mathijsmeulendijks/nrf9151-modbus/manufacturing/default/default.jlcpcb/default.bom.csv

Designator | Footprint | Quantity | Manufacturer | Partnumber | LCSC Part # | Comment
C1, C2, C6, C8, C11, C12, C17, C20, C24, C25, C29, C35, C39 | Murata_Electronics_GRM155F51C104ZA01D | 13 | Murata Electronics | GRM155F51C104ZA01D | C363930 | 100nF 16V
C3, C4 | KEMET_C0402C220K4RACAUTO | 2 | KEMET | C0402C220K4RACAUTO | C1864677 | 22pF ±10% 16V
C5 | TDK_C1608X5R1V475KT000E | 1 | TDK | C1608X5R1V475KT000E | C329940 | 4.7µF ±10% 35V
C7, C15, C16, C19, C34, C38 | HRE_CGA0603X5R105K350JT | 6 | HRE | CGA0603X5R105K350JT | C6119865 | 1µF ±10% 35V
C9, C26 | TDK_C3216X6S1A476MTJ00E | 2 | TDK | C3216X6S1A476MTJ00E | C432922 | 47µF ±20% 10V
C10, C13, C22, C32, C36 | FH_0805F106M100NT | 5 | FH | 0805F106M100NT | C91158 | 10µF ±20% 10V
C14, C21, C33, C37 | Walsin_Tech_Corp_0402B103K500 | 4 | Walsin Tech Corp | 0402B103K500 | C83062 | 10nF 50V
C18 | SANYEAR_C1206X5R107M160NT | 1 | SANYEAR | C1206X5R107M160NT | C2911415 | 100µF 16V
C23 | FOJAN_FCC0805X226M100FT | 1 | FOJAN | FCC0805X226M100FT | C5137600 | 22µF ±20% 10V
C27, C28, C30, C31 | Murata_Electronics_GCM188R71E104JA57D | 4 | Murata Electronics | GCM188R71E104JA57D | C437462 | 100nF ±5% 25V
Card1 | XKB_Connection_XKSIM_008 | 1 | XKB Connection | XKSIM-008 | C381069
D1, D2, D3, D4 | Nexperia_PESD5V0F1BL_315 | 4 | Nexperia | PESD5V0F1BL,315 | C45961
D5 | STMicroelectronics_USBLC6_2SC6 | 1 | STMicroelectronics | USBLC6-2SC6 | C7519
D6 | Diodes_Incorporated_SMAJ5_0A_13_F | 1 | Diodes Incorporated | SMAJ5.0A-13-F | C87074
F1 | Xucheng_Elec_5x20_BLX_AType_Fuse_holder_XC_7 | 1 | Xucheng Elec | 5x20 BLX-AType Fuse holder XC-7 | C3131
L1 | Murata_Electronics_BLM18KG300TN1D | 1 | Murata Electronics | BLM18KG300TN1D | C88982
Q1 | Alpha_Omega_Semicon_AO4407A | 1 | Alpha & Omega Semicon | AO4407A | C16072
R1, R6, R11, R12, R19, R20, R22 | YAGEO_RT0402DRE0710KL | 7 | YAGEO | RT0402DRE0710KL | C326912 | 10kΩ ±0.5% 62.5mW 50V
R2, R21 | YAGEO_RT0603BRD07121RL | 2 | YAGEO | RT0603BRD07121RL | C705721 | 121Ω ±0.1% 100mW 75V
R3, R4 | Viking_Tech_CR_02FL6_4K7 | 2 | Viking Tech | CR-02FL6---4K7 | C406732 | 4.7kΩ ±1% 62.5mW 50V
R5 | KOA_Speer_Elec_RN73H1ETTP49R9D10 | 1 | KOA Speer Elec | RN73H1ETTP49R9D10 | C4165090 | 49.9Ω ±0.5% 62.5mW
R7, R8, R9 | ROHM_Semicon_MCR01MZPJ220 | 3 | ROHM Semicon | MCR01MZPJ220 | C2941037 | 22Ω ±5% 100mW 50V
R10, R14 | HKR_AST02100KJ | 2 | HKR | AST02100KJ | C49330106 | 100kΩ ±5% 62.5mW 50V
R13 | FH_RC_02K102JT | 1 | FH | RC-02K102JT | C140196 | 1kΩ ±5% 62.5mW 50V
R15, R16 | Ever_Ohms_Tech_QR0402F100KQ10Z | 2 | Ever Ohms Tech | QR0402F100KQ10Z | C176106 | 100kΩ ±1% 63mW 50V
R17 | Vishay_Intertech_RCWE1206R100FKEA | 1 | Vishay Intertech | RCWE1206R100FKEA | C844256 | 100mΩ ±1% 500mW
R18 | ROHM_Semicon_TRR01MZPF4022 | 1 | ROHM Semicon | TRR01MZPF4022 | C5966383 | 40.2kΩ ±1% 63mW
RF1, RF2 | ECT_ECT818000500 | 2 | ECT | ECT818000500 | C437254
RJ1 | Shenzhen_Kinghelm_Elec_KH_RJ45_56_8P8C | 1 | Shenzhen Kinghelm Elec | KH-RJ45-56-8P8C | C2683359
SW1 | Korean_Hroparts_Elec_K2_1102SP_D4SC_04 | 1 | Korean Hroparts Elec | K2-1102SP-D4SC-04 | C223763
U1 | Microchip_Tech_MCP2515T_I_SO | 1 | Microchip Tech | MCP2515T-I/SO | C153782
U2 | Texas_Instruments_SN65HVD230DR | 1 | Texas Instruments | SN65HVD230DR | C12084
U3 | Nordic_Semicon_NRF9151_LACA_R | 1 | Nordic Semicon | NRF9151-LACA-R | C42236596
U4 | JLCPCB_Assembly_FTSH_105_01_F_D_K | 1 | JLCPCB Assembly | FTSH-105-01-F-D-K | C9900011230
U5 | Texas_Instruments_INA180A1IDBVR | 1 | Texas Instruments | INA180A1IDBVR | C122228
U6 | Microchip_Tech_MCP6001UT_I_OT | 1 | Microchip Tech | MCP6001UT-I/OT | C21403
U7 | MW_IRM_10_5 | 1 | MW | IRM-10-5 | C2857903
U8 | Texas_Instruments_TLV1117_33CDCYR | 1 | Texas Instruments | TLV1117-33CDCYR | C91728
U9, U10 | Texas_Instruments_LM66100DCKR | 2 | Texas Instruments | LM66100DCKR | C2869734
U11 | JLCPCB_Assembly_0_47F5_5VDC | 1 | JLCPCB Assembly | 0.47F5.5VDC | C9900166265
U12 | Diodes_Incorporated_APX803L_29SA_7 | 1 | Diodes Incorporated | APX803L-29SA-7 | C2066862
U13 | Texas_Instruments_MAX3232IPWR | 1 | Texas Instruments | MAX3232IPWR | C113205
U14 | Texas_Instruments_ISOW1412DFMR | 1 | Texas Instruments | ISOW1412DFMR | C5216548
U15 | Texas_Instruments_TMP117AIDRVR | 1 | Texas Instruments | TMP117AIDRVR | C699536
XTAL1 | IQD_LFXTAL056516REEL | 1 | IQD | LFXTAL056516REEL | C6078914 | 8MHz
