mathijsmeulendijks/nrf9151-modbus/layouts/default/default.pcb.hl/3d_models/JLCPCB_Assembly_0_47F5_5VDC/JLCPCB_Assembly_0_47F5_5VDC.3dmodel.step

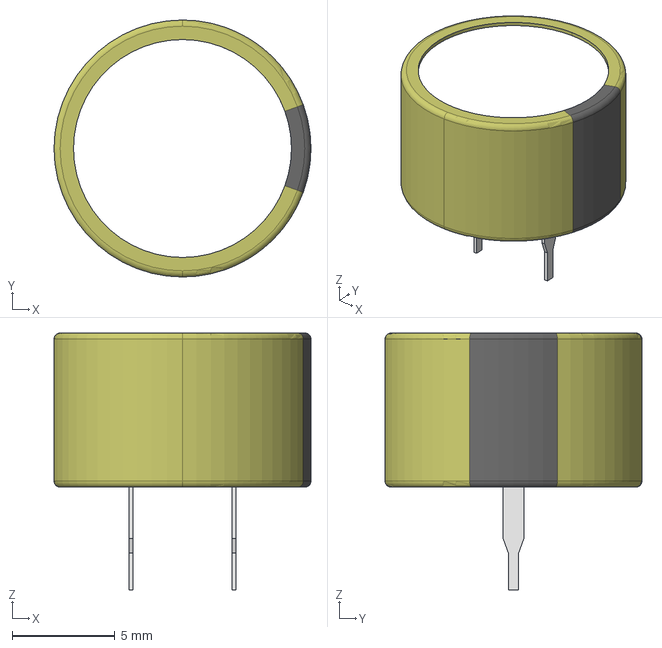
[picture p1: CAD file, 2026-10-01]
layouts/default/default.pcb.hl/3d_models/JLCPCB_Assembly_0_47F5_5VDC/JLCPCB_Assembly_0_47F5_5VDC.3dmodel.step
12.5 x 12.5 x 12.5 mm
