mathijsmeulendijks/nrf9151-modbus/layouts/default/default.pcb.hl/3d_models/JLCPCB_Assembly_FTSH_105_01_F_D_K/JLCPCB_Assembly_FTSH_105_01_F_D_K.3dmodel.step

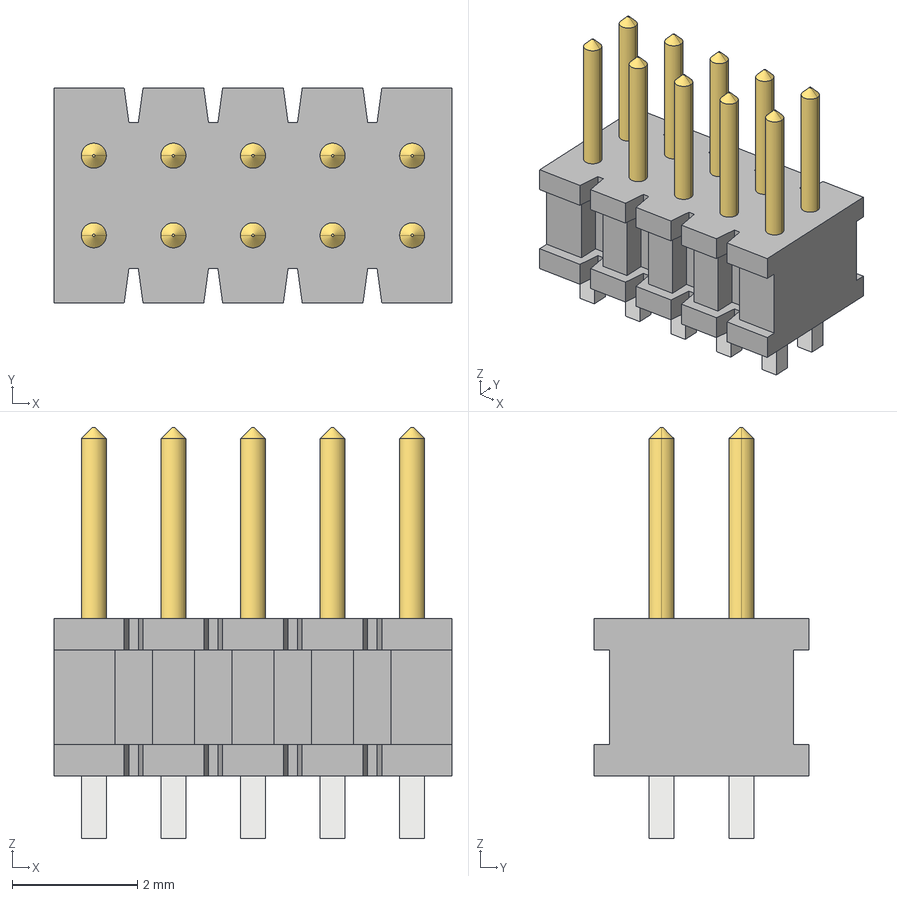
[picture p2: CAD file, 2026-10-01]
layouts/default/default.pcb.hl/3d_models/JLCPCB_Assembly_FTSH_105_01_F_D_K/JLCPCB_Assembly_FTSH_105_01_F_D_K.3dmodel.step
6.35 x 3.43 x 6.56 mm
