mathijsmeulendijks/nrf9151-modbus/layouts/default/default.pcb.hl/3d_models/Diodes_Incorporated_APX803L_29SA_7/Diodes_Incorporated_APX803L_29SA_7.3dmodel.step

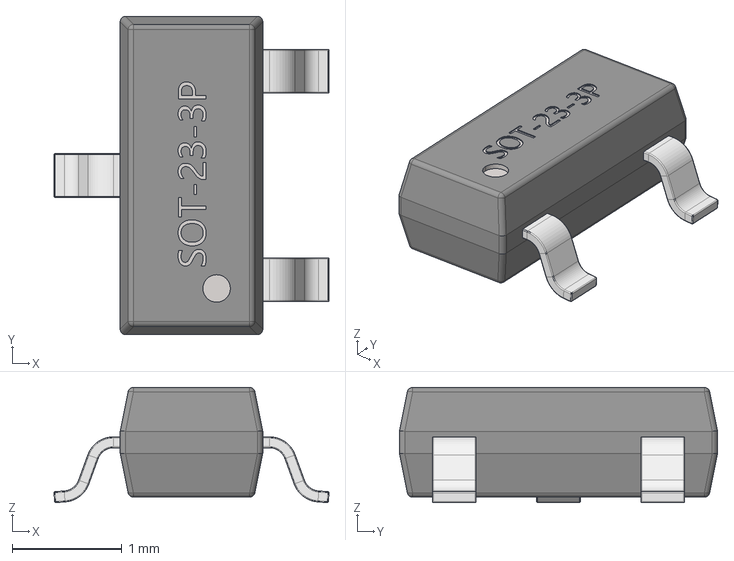
[picture p3: CAD file, 2026-10-01]
layouts/default/default.pcb.hl/3d_models/Diodes_Incorporated_APX803L_29SA_7/Diodes_Incorporated_APX803L_29SA_7.3dmodel.step
2.51 x 2.90 x 1.05 mm
