mathijsmeulendijks/nrf9151-modbus/layouts/default/default.pcb.hl/3d_models/Diodes_Incorporated_SMAJ5_0A_13_F/Diodes_Incorporated_SMAJ5_0A_13_F.3dmodel.step

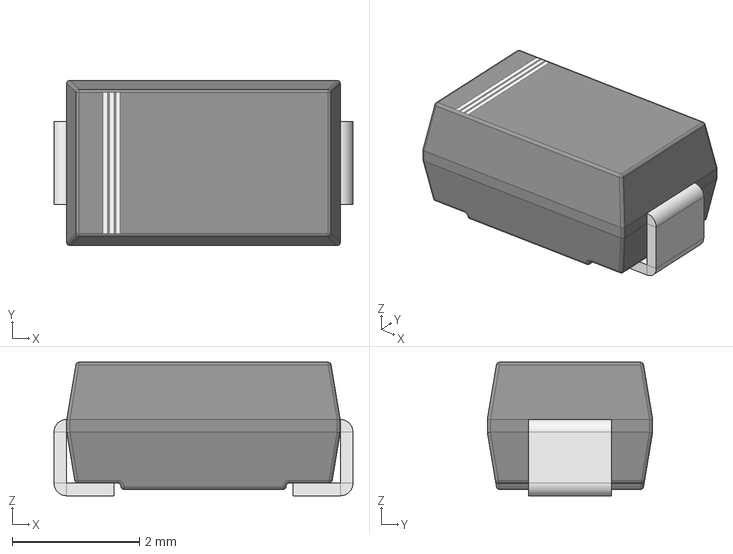
[picture p4: CAD file, 2026-10-01]
layouts/default/default.pcb.hl/3d_models/Diodes_Incorporated_SMAJ5_0A_13_F/Diodes_Incorporated_SMAJ5_0A_13_F.3dmodel.step
4.70 x 2.60 x 2.10 mm
