mathijsmeulendijks/nrf9151-modbus/layouts/default/default.pcb.hl/3d_models/ECT_ECT818000500/ECT_ECT818000500.3dmodel.step

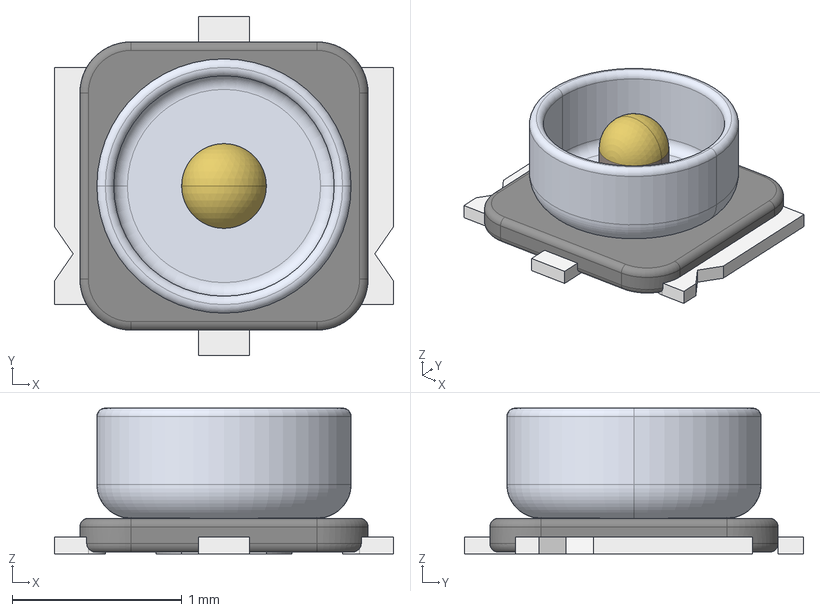
[picture p5: CAD file, 2026-10-01]
layouts/default/default.pcb.hl/3d_models/ECT_ECT818000500/ECT_ECT818000500.3dmodel.step
2.00 x 2.00 x 0.86 mm
