mathijsmeulendijks/nrf9151-modbus/layouts/default/default.pcb.hl/3d_models/FH_0805F106M100NT/FH_0805F106M100NT.3dmodel.step

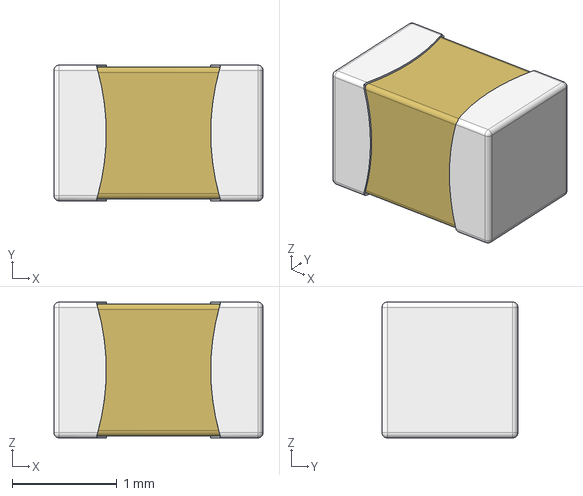
[picture p6: CAD file, 2026-10-01]
layouts/default/default.pcb.hl/3d_models/FH_0805F106M100NT/FH_0805F106M100NT.3dmodel.step
2.00 x 1.30 x 1.30 mm
