mathijsmeulendijks/nrf9151-modbus/layouts/default/default.pcb.hl/3d_models/HRE_CGA0603X5R105K350JT/HRE_CGA0603X5R105K350JT.3dmodel.step

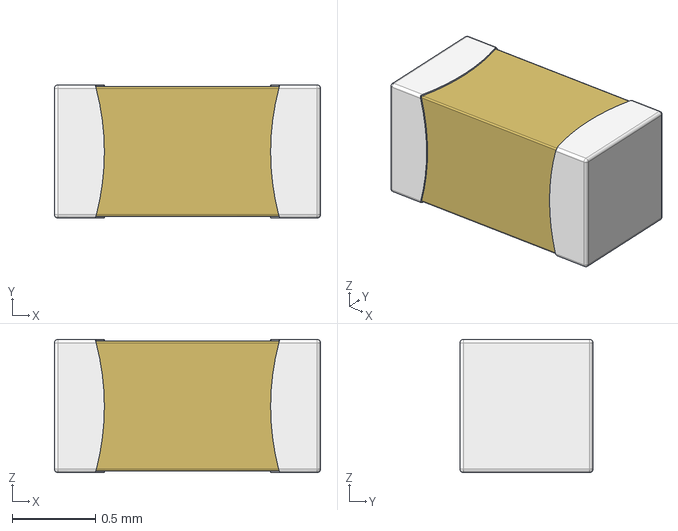
[picture p7: CAD file, 2026-10-01]
layouts/default/default.pcb.hl/3d_models/HRE_CGA0603X5R105K350JT/HRE_CGA0603X5R105K350JT.3dmodel.step
1.60 x 0.8 x 0.8 mm
