mathijsmeulendijks/nrf9151-modbus/layouts/default/default.pcb.hl/3d_models/IQD_LFXTAL056516REEL/IQD_LFXTAL056516REEL.3dmodel.step

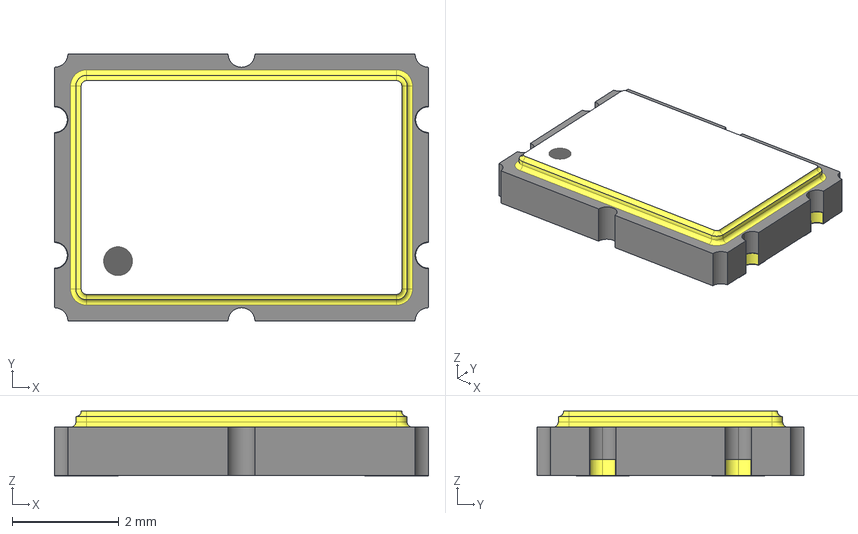
[picture p8: CAD file, 2026-10-01]
layouts/default/default.pcb.hl/3d_models/IQD_LFXTAL056516REEL/IQD_LFXTAL056516REEL.3dmodel.step
7.00 x 5.00 x 1.21 mm
