mathijsmeulendijks/nrf9151-modbus/layouts/default/default.pcb.hl/3d_models/Korean_Hroparts_Elec_K2_1102SP_D4SC_04/Korean_Hroparts_Elec_K2_1102SP_D4SC_04.3dmodel.step

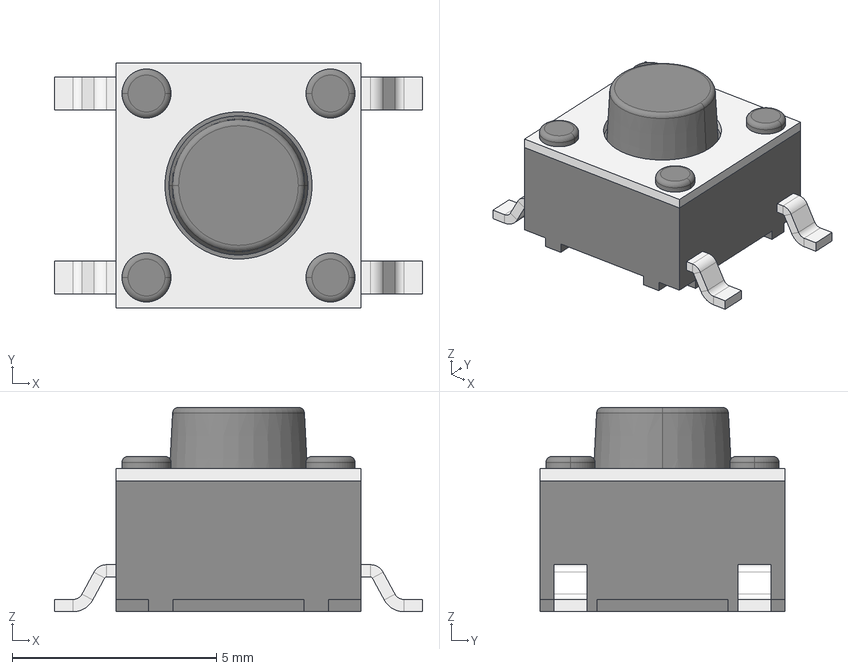
[picture p9: CAD file, 2026-10-01]
layouts/default/default.pcb.hl/3d_models/Korean_Hroparts_Elec_K2_1102SP_D4SC_04/Korean_Hroparts_Elec_K2_1102SP_D4SC_04.3dmodel.step
9.00 x 6.00 x 5.00 mm
