mathijsmeulendijks/nrf9151-modbus/layouts/default/default.pcb.hl/3d_models/Microchip_Tech_MCP2515T_I_SO/Microchip_Tech_MCP2515T_I_SO.3dmodel.step

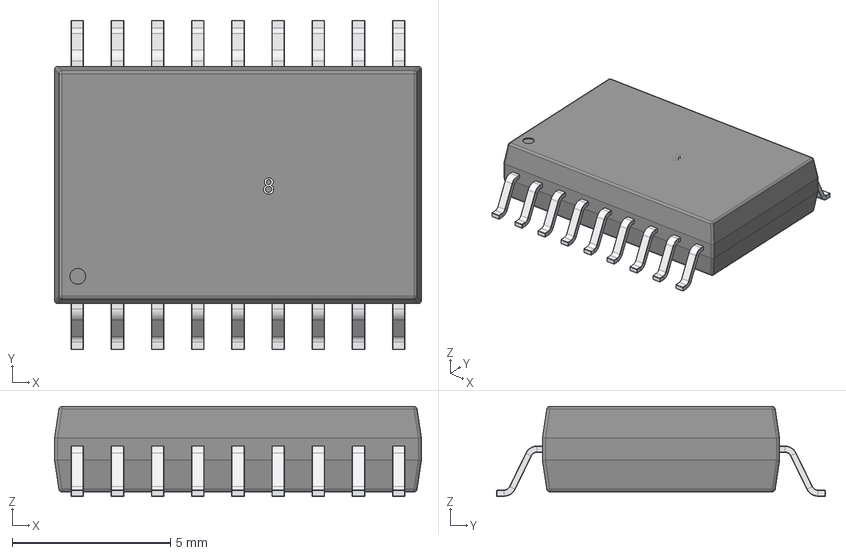
[picture p10: CAD file, 2026-10-01]
layouts/default/default.pcb.hl/3d_models/Microchip_Tech_MCP2515T_I_SO/Microchip_Tech_MCP2515T_I_SO.3dmodel.step
11.6 x 10.4 x 2.85 mm
