mathijsmeulendijks/nrf9151-modbus/layouts/default/default.pcb.hl/3d_models/Microchip_Tech_MCP6001UT_I_OT/Microchip_Tech_MCP6001UT_I_OT.3dmodel.step

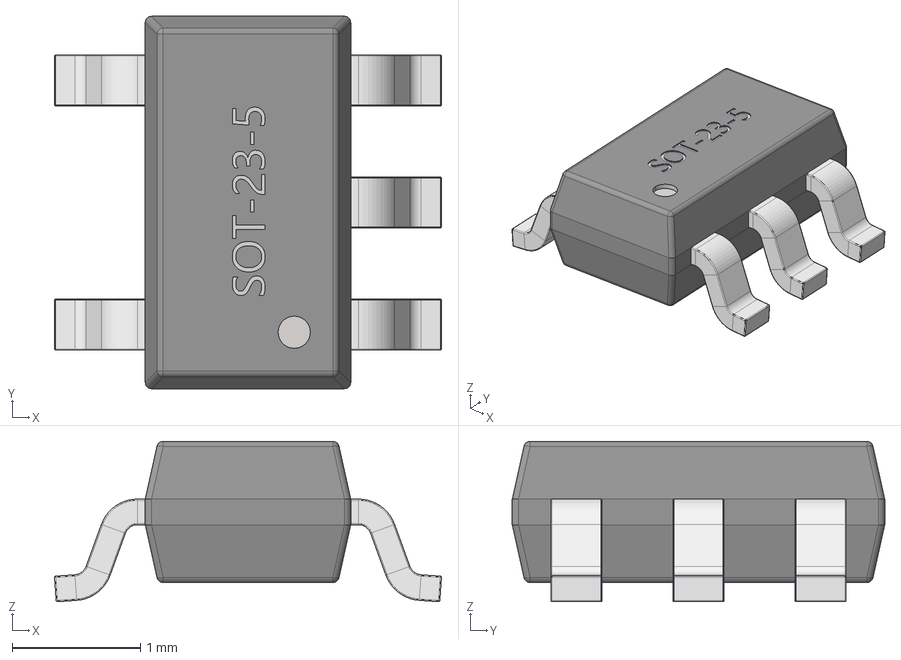
[picture p11: CAD file, 2026-10-01]
layouts/default/default.pcb.hl/3d_models/Microchip_Tech_MCP6001UT_I_OT/Microchip_Tech_MCP6001UT_I_OT.3dmodel.step
3.01 x 2.90 x 1.25 mm
