mathijsmeulendijks/nrf9151-modbus/layouts/default/default.pcb.hl/3d_models/Murata_Electronics_BLM18KG300TN1D/Murata_Electronics_BLM18KG300TN1D.3dmodel.step

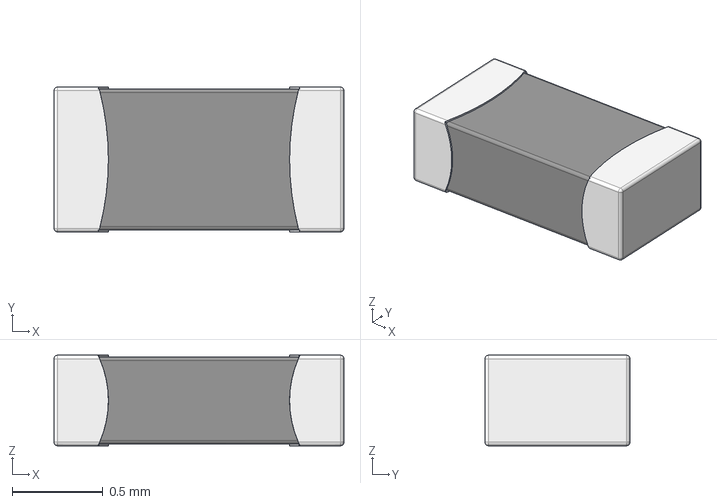
[picture p12: CAD file, 2026-10-01]
layouts/default/default.pcb.hl/3d_models/Murata_Electronics_BLM18KG300TN1D/Murata_Electronics_BLM18KG300TN1D.3dmodel.step
1.60 x 0.8 x 0.5 mm
