mathijsmeulendijks/nrf9151-modbus/layouts/default/default.pcb.hl/3d_models/Murata_Electronics_GRM155F51C104ZA01D/Murata_Electronics_GRM155F51C104ZA01D.3dmodel.step

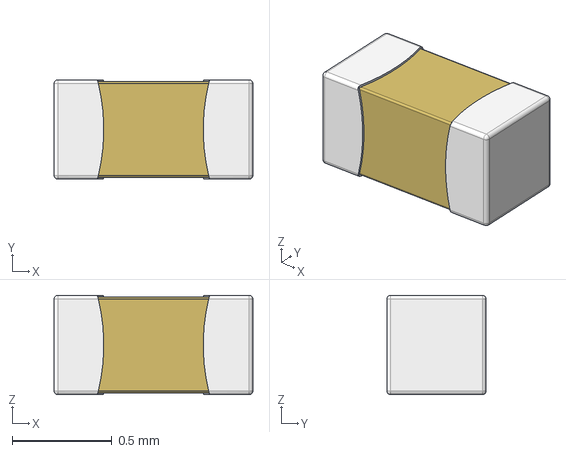
[picture p13: CAD file, 2026-10-01]
layouts/default/default.pcb.hl/3d_models/Murata_Electronics_GRM155F51C104ZA01D/Murata_Electronics_GRM155F51C104ZA01D.3dmodel.step
1.00 x 0.5 x 0.5 mm
