mathijsmeulendijks/nrf9151-modbus/layouts/default/default.pcb.hl/3d_models/MW_IRM_10_5/MW_IRM_10_5.3dmodel.step

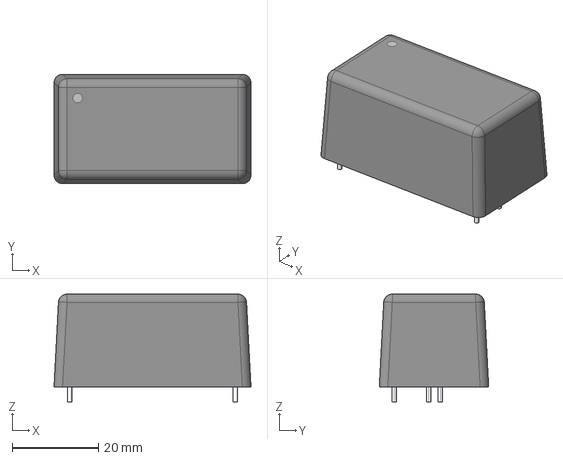
[picture p14: CAD file, 2026-10-01]
layouts/default/default.pcb.hl/3d_models/MW_IRM_10_5/MW_IRM_10_5.3dmodel.step
45.7 x 25.4 x 25.0 mm
