mathijsmeulendijks/nrf9151-modbus/layouts/default/default.pcb.hl/3d_models/Nexperia_PESD5V0F1BL_315/Nexperia_PESD5V0F1BL_315.3dmodel.step

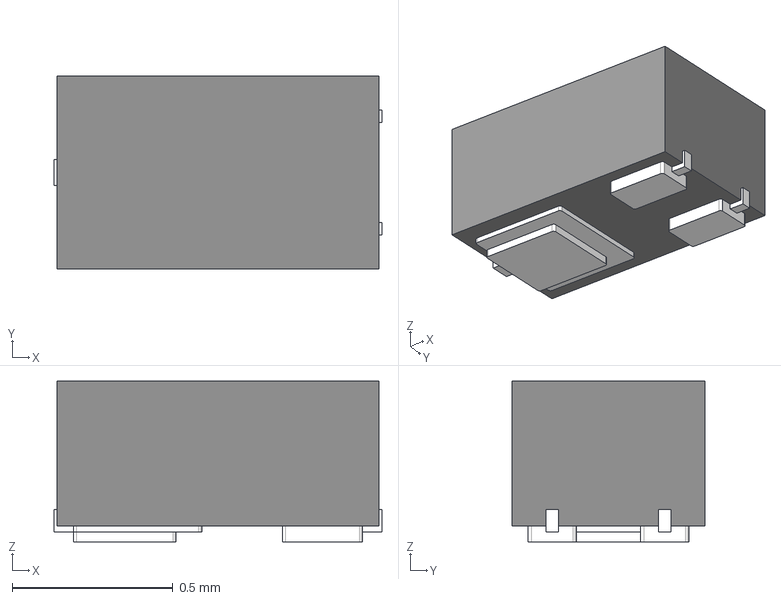
[picture p15: CAD file, 2026-10-01]
layouts/default/default.pcb.hl/3d_models/Nexperia_PESD5V0F1BL_315/Nexperia_PESD5V0F1BL_315.3dmodel.step
1.02 x 0.6 x 0.5 mm
