mathijsmeulendijks/nrf9151-modbus/layouts/default/default.pcb.hl/3d_models/Nordic_Semicon_NRF9151_LACA_R/Nordic_Semicon_NRF9151_LACA_R.3dmodel.step

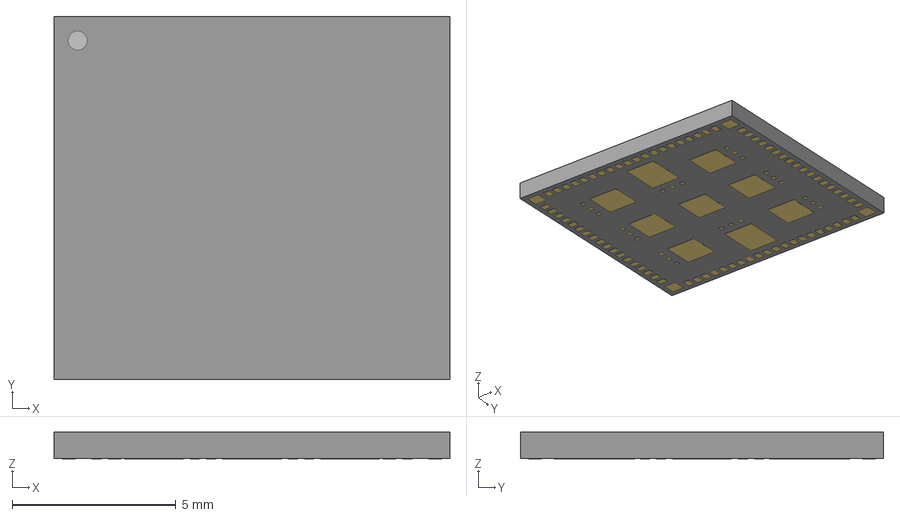
[picture p16: CAD file, 2026-10-01]
layouts/default/default.pcb.hl/3d_models/Nordic_Semicon_NRF9151_LACA_R/Nordic_Semicon_NRF9151_LACA_R.3dmodel.step
12.1 x 11.1 x 0.81 mm
