mathijsmeulendijks/nrf9151-modbus/layouts/default/default.pcb.hl/3d_models/ROHM_Semicon_TRR01MZPF4022/ROHM_Semicon_TRR01MZPF4022.3dmodel.step

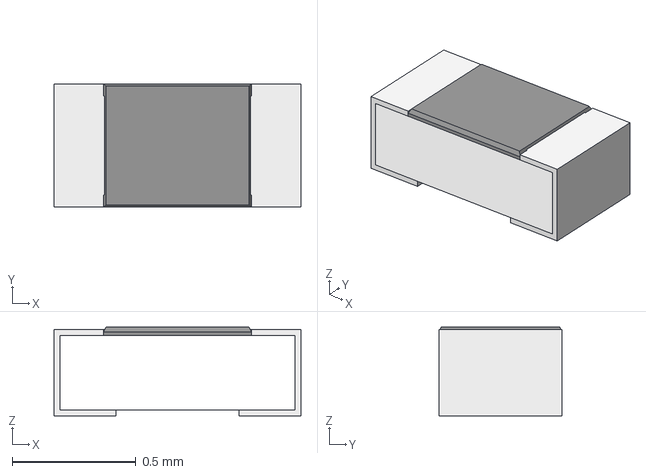
[picture p17: CAD file, 2026-10-01]
layouts/default/default.pcb.hl/3d_models/ROHM_Semicon_TRR01MZPF4022/ROHM_Semicon_TRR01MZPF4022.3dmodel.step
1.00 x 0.5 x 0.36 mm
