mathijsmeulendijks/nrf9151-modbus/layouts/default/default.pcb.hl/3d_models/Shenzhen_Kinghelm_Elec_KH_RJ45_56_8P8C/Shenzhen_Kinghelm_Elec_KH_RJ45_56_8P8C.3dmodel.step

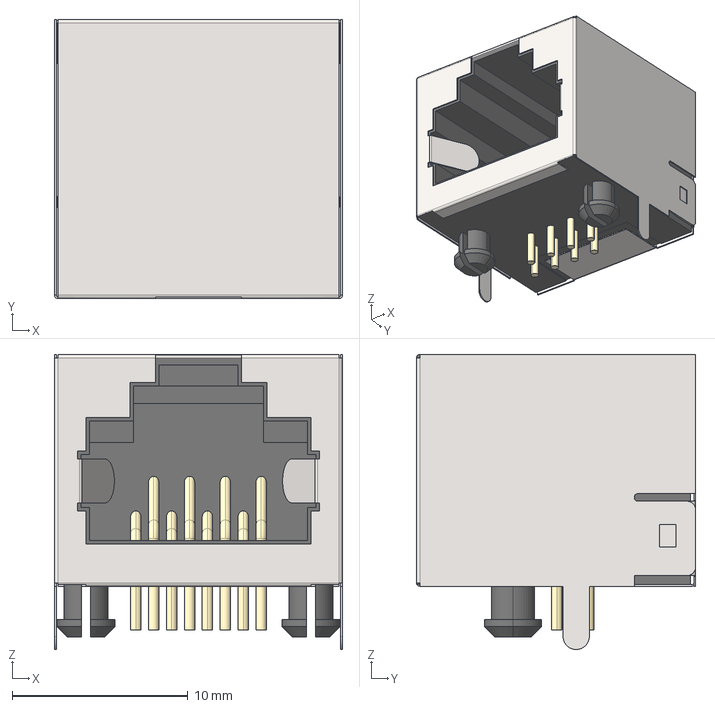
[picture p18: CAD file, 2026-10-01]
layouts/default/default.pcb.hl/3d_models/Shenzhen_Kinghelm_Elec_KH_RJ45_56_8P8C/Shenzhen_Kinghelm_Elec_KH_RJ45_56_8P8C.3dmodel.step
16.4 x 15.9 x 16.8 mm
