mathijsmeulendijks/nrf9151-modbus/layouts/default/default.pcb.hl/3d_models/STMicroelectronics_USBLC6_2SC6/STMicroelectronics_USBLC6_2SC6.3dmodel.step

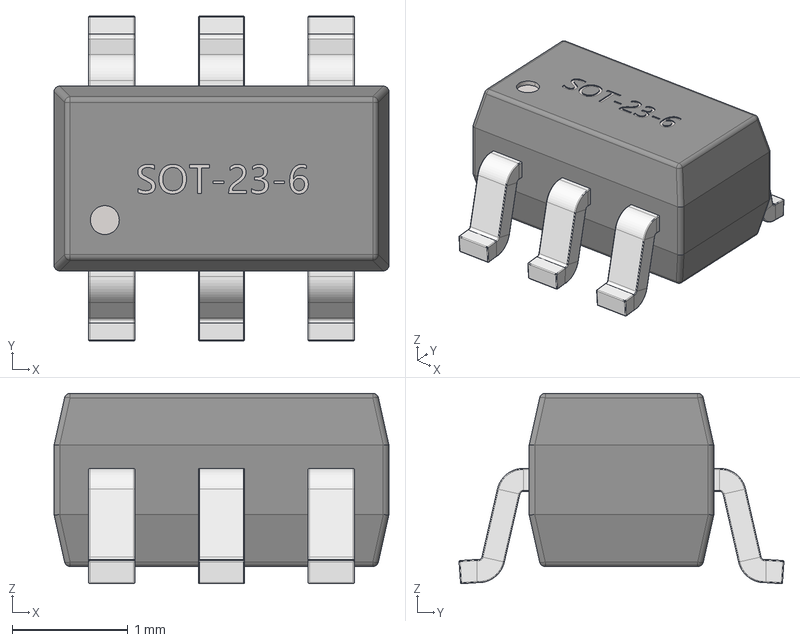
[picture p19: CAD file, 2026-10-01]
layouts/default/default.pcb.hl/3d_models/STMicroelectronics_USBLC6_2SC6/STMicroelectronics_USBLC6_2SC6.3dmodel.step
2.90 x 2.81 x 1.65 mm
