mathijsmeulendijks/nrf9151-modbus/layouts/default/default.pcb.hl/3d_models/TDK_C3216X6S1A476MTJ00E/TDK_C3216X6S1A476MTJ00E.3dmodel.step

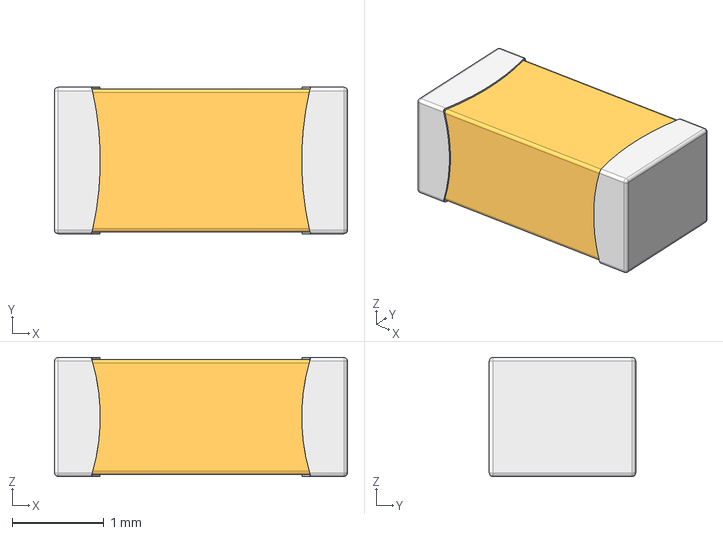
[picture p20: CAD file, 2026-10-01]
layouts/default/default.pcb.hl/3d_models/TDK_C3216X6S1A476MTJ00E/TDK_C3216X6S1A476MTJ00E.3dmodel.step
3.20 x 1.60 x 1.30 mm
