mathijsmeulendijks/nrf9151-modbus/layouts/default/default.pcb.hl/3d_models/Texas_Instruments_ISOW1412DFMR/Texas_Instruments_ISOW1412DFMR.3dmodel.step

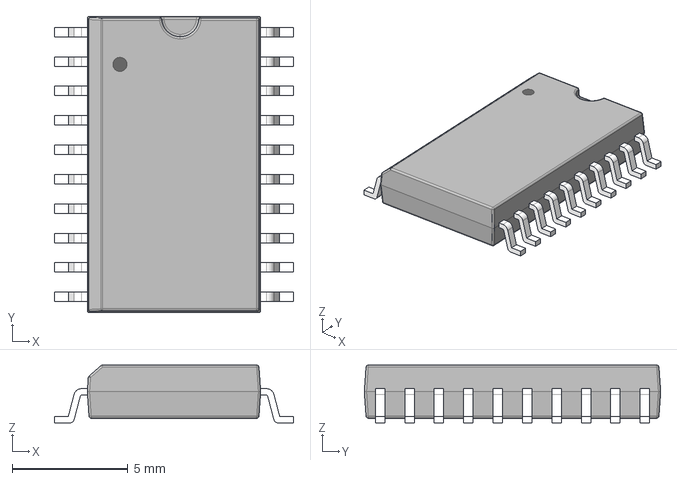
[picture p21: CAD file, 2026-10-01]
layouts/default/default.pcb.hl/3d_models/Texas_Instruments_ISOW1412DFMR/Texas_Instruments_ISOW1412DFMR.3dmodel.step
10.3 x 12.8 x 2.50 mm
