mathijsmeulendijks/nrf9151-modbus/layouts/default/default.pcb.hl/3d_models/Texas_Instruments_LM66100DCKR/Texas_Instruments_LM66100DCKR.3dmodel.step

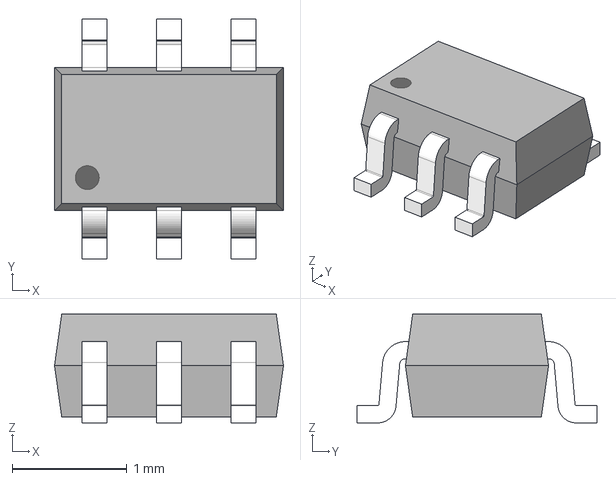
[picture p22: CAD file, 2026-10-01]
layouts/default/default.pcb.hl/3d_models/Texas_Instruments_LM66100DCKR/Texas_Instruments_LM66100DCKR.3dmodel.step
2.00 x 2.10 x 0.95 mm
