mathijsmeulendijks/nrf9151-modbus/layouts/default/default.pcb.hl/3d_models/Texas_Instruments_MAX3232IPWR/Texas_Instruments_MAX3232IPWR.3dmodel.step

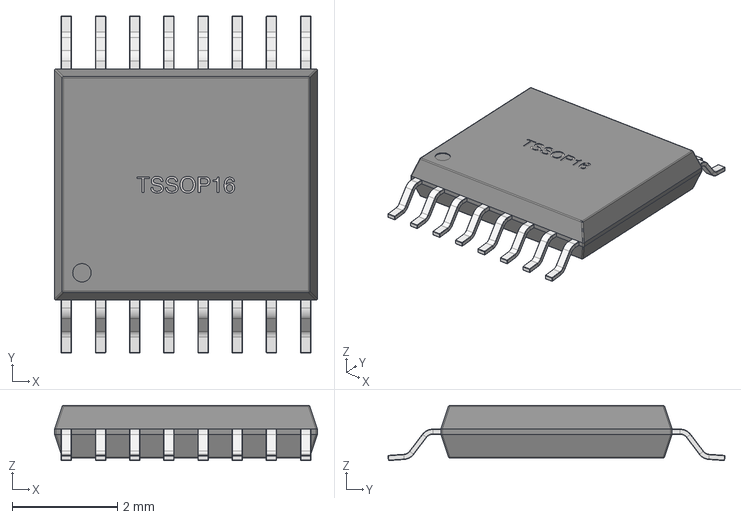
[picture p23: CAD file, 2026-10-01]
layouts/default/default.pcb.hl/3d_models/Texas_Instruments_MAX3232IPWR/Texas_Instruments_MAX3232IPWR.3dmodel.step
5.00 x 6.41 x 1.05 mm
