mathijsmeulendijks/nrf9151-modbus/layouts/default/default.pcb.hl/3d_models/Texas_Instruments_SN65HVD230DR/Texas_Instruments_SN65HVD230DR.3dmodel.step

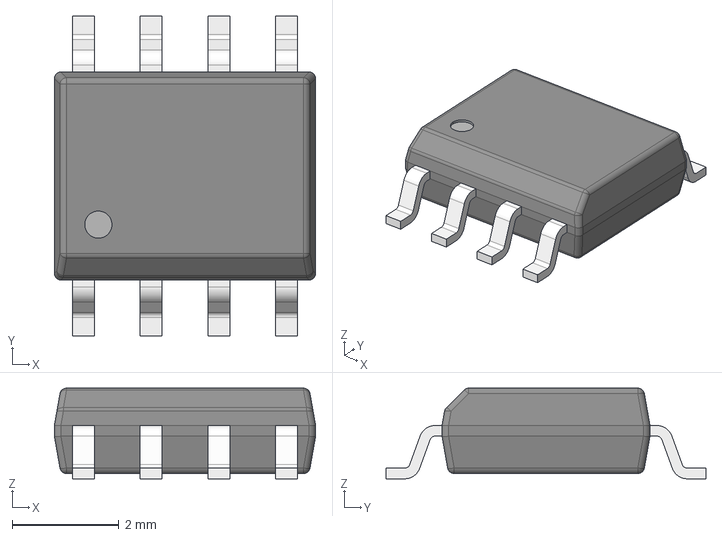
[picture p24: CAD file, 2026-10-01]
layouts/default/default.pcb.hl/3d_models/Texas_Instruments_SN65HVD230DR/Texas_Instruments_SN65HVD230DR.3dmodel.step
4.90 x 6.00 x 1.70 mm
