mathijsmeulendijks/nrf9151-modbus/layouts/default/default.pcb.hl/3d_models/Texas_Instruments_TLV1117_33CDCYR/Texas_Instruments_TLV1117_33CDCYR.3dmodel.step

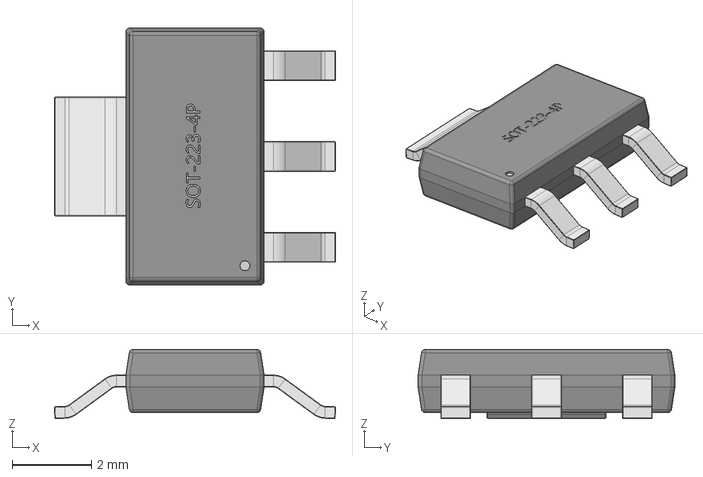
[picture p25: CAD file, 2026-10-01]
layouts/default/default.pcb.hl/3d_models/Texas_Instruments_TLV1117_33CDCYR/Texas_Instruments_TLV1117_33CDCYR.3dmodel.step
7.11 x 6.50 x 1.75 mm
