mathijsmeulendijks/nrf9151-modbus/layouts/default/default.pcb.hl/3d_models/Texas_Instruments_TMP117AIDRVR/Texas_Instruments_TMP117AIDRVR.3dmodel.step

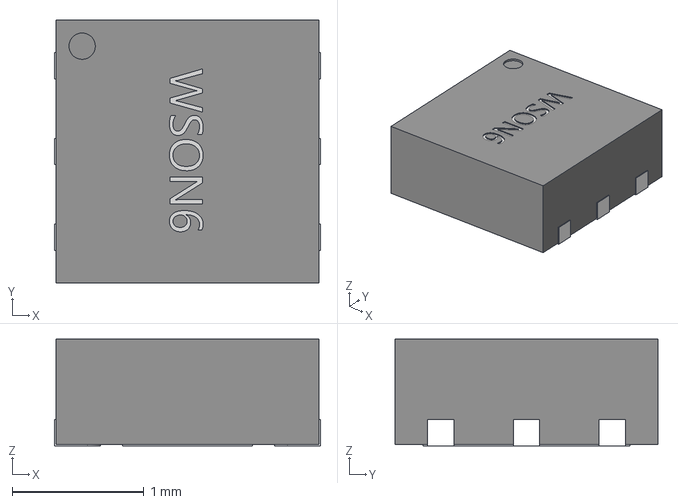
[picture p26: CAD file, 2026-10-01]
layouts/default/default.pcb.hl/3d_models/Texas_Instruments_TMP117AIDRVR/Texas_Instruments_TMP117AIDRVR.3dmodel.step
2.02 x 2.00 x 0.81 mm
