mathijsmeulendijks/nrf9151-modbus/layouts/default/default.pcb.hl/3d_models/Vishay_Intertech_RCWE1206R100FKEA/Vishay_Intertech_RCWE1206R100FKEA.3dmodel.step

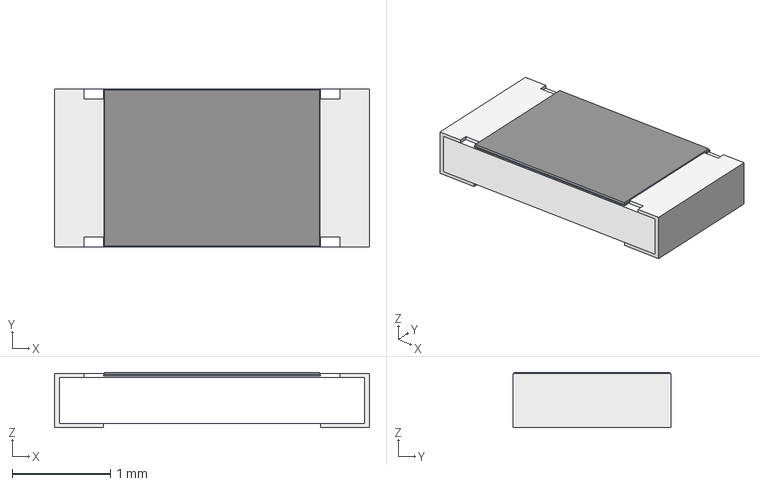
[picture p27: CAD file, 2026-10-01]
layouts/default/default.pcb.hl/3d_models/Vishay_Intertech_RCWE1206R100FKEA/Vishay_Intertech_RCWE1206R100FKEA.3dmodel.step
3.20 x 1.60 x 0.56 mm
