mathijsmeulendijks/nrf9151-modbus/layouts/default/default.pcb.hl/3d_models/XKB_Connection_XKSIM_008/XKB_Connection_XKSIM_008.3dmodel.step

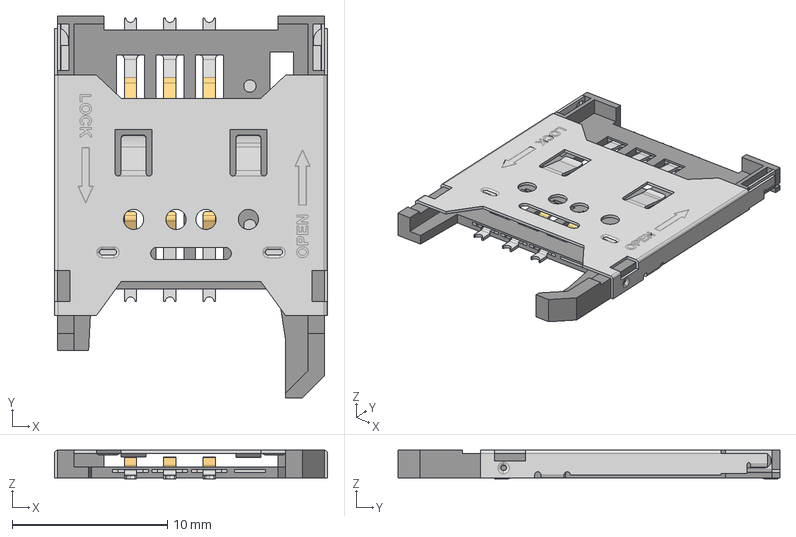
[picture p28: CAD file, 2026-10-01]
layouts/default/default.pcb.hl/3d_models/XKB_Connection_XKSIM_008/XKB_Connection_XKSIM_008.3dmodel.step
17.6 x 24.6 x 1.85 mm
