mathijsmeulendijks/nrf9151-modbus/layouts/default/default.pcb.hl/3d_models/Xucheng_Elec_5x20_BLX_AType_Fuse_holder_XC_7/Xucheng_Elec_5x20_BLX_AType_Fuse_holder_XC_7.3dmodel.step

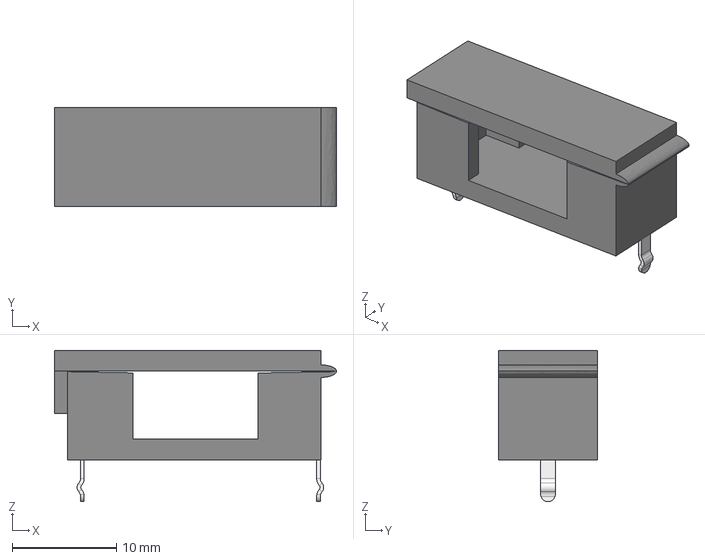
[picture p29: CAD file, 2026-10-01]
layouts/default/default.pcb.hl/3d_models/Xucheng_Elec_5x20_BLX_AType_Fuse_holder_XC_7/Xucheng_Elec_5x20_BLX_AType_Fuse_holder_XC_7.3dmodel.step
27.0 x 9.50 x 14.5 mm
