mathijsmeulendijks/nrf9151-modbus/layouts/default/default.pcb.hl/3d_models/YAGEO_RT0603BRD07121RL/YAGEO_RT0603BRD07121RL.3dmodel.step

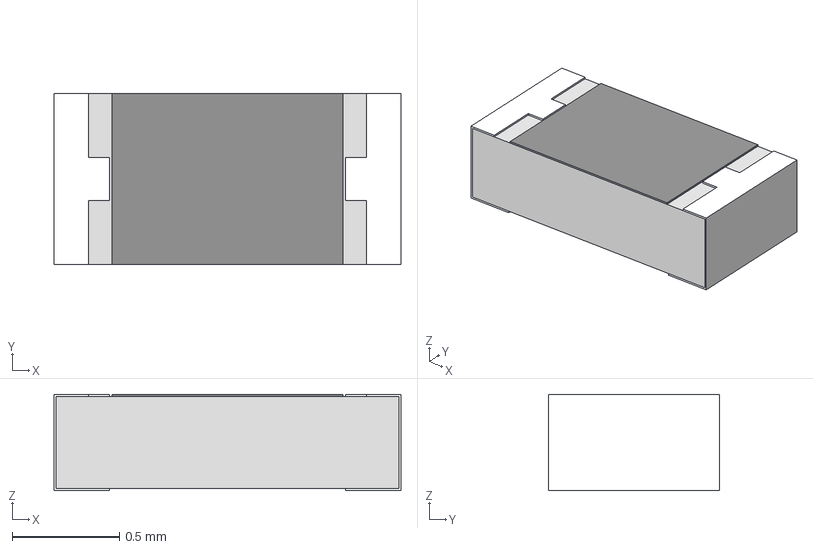
[picture p30: CAD file, 2026-10-01]
layouts/default/default.pcb.hl/3d_models/YAGEO_RT0603BRD07121RL/YAGEO_RT0603BRD07121RL.3dmodel.step
1.62 x 0.8 x 0.45 mm
