mathijsmeulendijks/nrf9151-modbus/(list of files, drawings)

Other design files:
layouts/default/default.pcb.hl/easyeda_decorators.ato.json
