mathijsmeulendijks/nrf9151-modbus/nrf9151-modbus.kicad_pcb

## KiCad design nrf9151-modbus.kicad_pcb (2026-10-02)

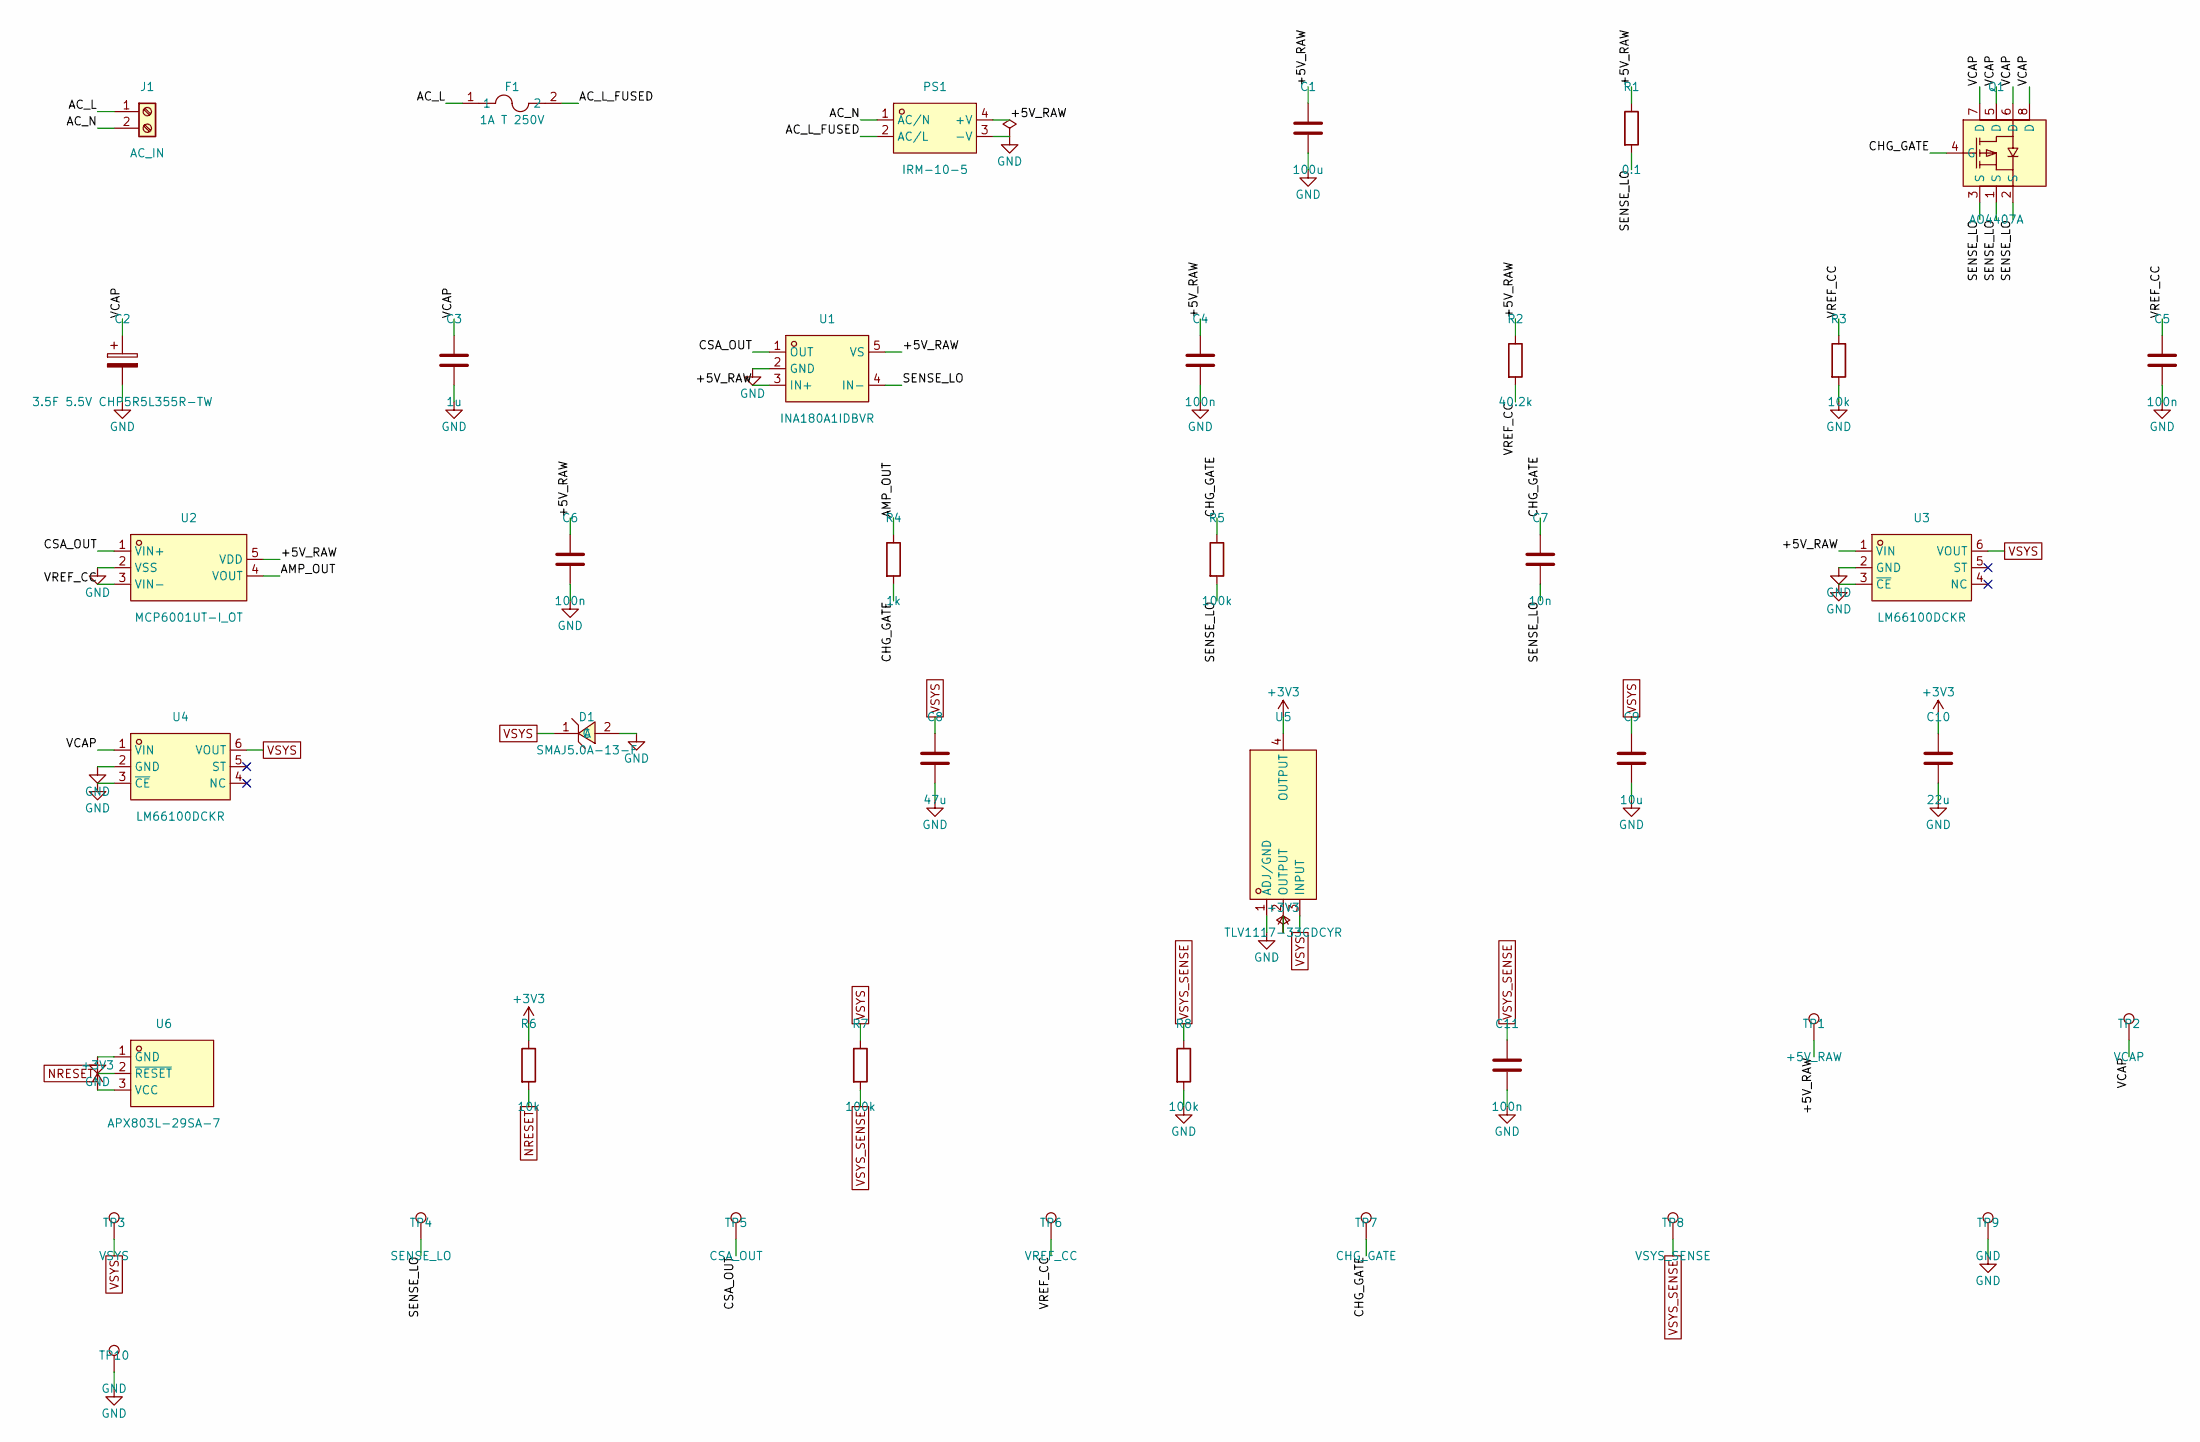
[picture p31: schematic power.kicad_sch]

Parts:
C1: 100u; C_1206_3216Metric; LCSC C2911415
C2: 3.5F 5.5V CHP5R5L355R-TW; CAP-TH_CDA_CHT-DA_2xD10_P15.5mm; LCSC C2925904
C3: 1u; C_0402_1005Metric; LCSC C52923
C4, C5, C6, C11: 100n; C_0402_1005Metric; LCSC C1525
C7: 10n; C_0402_1005Metric; LCSC C15195
C8: 47u; C_1206_3216Metric; LCSC C432922
C9: 10u; C_0603_1608Metric; LCSC C19702
C10: 22u; C_0603_1608Metric; LCSC C59461
D1: SMAJ5.0A-13-F; SMA_L4.3-W2.6-LS5.2-RD; LCSC C87074
F1: 1A T 250V; F2410; LCSC C136380
J1: AC_IN; TerminalBlock_Phoenix_MKDS-1,5-2-5.08_1x02_P5.08mm_Horizont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
PS1: IRM-10-5; PWRM-TH_4P-L45.7-W25.4-P8.0; LCSC C2857903
Q1: AO4407A; SOIC-8_L4.9-W3.9-P1.27-LS6.0-BL; LCSC C16072
R1: 0.1; R_1206_3216Metric; LCSC C844256
R2: 40.2k; R_0402_1005Metric; LCSC C5966383
R3, R6: 10k; R_0402_1005Metric; LCSC C25744
R4: 1k; R_0402_1005Metric; LCSC C11702
R5, R7, R8: 100k; R_0402_1005Metric; LCSC C25741
TP1: +5V_RAW; TestPoint_Pad_D1.5mm
TP2: VCAP; TestPoint_Pad_D1.5mm
TP3: VSYS; TestPoint_Pad_D1.5mm
TP4: SENSE_LO; TestPoint_Pad_D1.5mm
TP5: CSA_OUT; TestPoint_Pad_D1.5mm
TP6: VREF_CC; TestPoint_Pad_D1.5mm
TP7: CHG_GATE; TestPoint_Pad_D1.5mm
TP8: VSYS_SENSE; TestPoint_Pad_D1.5mm
TP9, TP10: GND; TestPoint_Pad_D1.5mm
U1: INA180A1IDBVR; SOT-23-5_L3.0-W1.7-P0.95-LS2.8-BR; LCSC C122228
U2: MCP6001UT-I_OT; SOT-23-5_L3.0-W1.7-P0.95-LS2.8-BR; LCSC C21403
U3, U4: LM66100DCKR; SC-70-6_L2.0-W1.3-P0.65-LS2.1-BL; LCSC C2869734
U5: TLV1117-33CDCYR; SOT-223_L6.5-W3.5-P2.30-LS7.0-BR; LCSC C91728
U6: APX803L-29SA-7; SOT-23-3_L2.9-W1.3-P1.90-LS2.4-BR; LCSC C2066862

Connections:
+3V3: C10.1, R6.1, U5.2 (OUTPUT), U5.4 (OUTPUT), U6.3 (VCC); also elsewhere on the board
/Power/+5V_RAW: C1.1, C4.1, C6.1, PS1.4 (+V), R1.1, R2.1, TP1.1, U1.3 (IN+), U1.5 (VS), U2.5 (VDD), U3.1 (VIN)
/Power/AC_L: F1.1, J1.1
/Power/AC_L_FUSED: F1.2, PS1.2 (AC/L)
/Power/AC_N: J1.2, PS1.1 (AC/N)
/Power/AMP_OUT: R4.1, U2.4 (VOUT)
/Power/CHG_GATE: C7.1, Q1.4 (G), R4.2, R5.1, TP7.1
/Power/CSA_OUT: TP5.1, U1.1 (OUT), U2.1 (VIN+)
/Power/SENSE_LO: C7.2, Q1.1 (S), Q1.2 (S), Q1.3 (S), R1.2, R5.2, TP4.1, U1.4 (IN-)
/Power/VCAP: C2.1, C3.1, Q1.5 (D), Q1.6 (D), Q1.7 (D), Q1.8 (D), TP2.1, U4.1 (VIN)
/Power/VREF_CC: C5.1, R2.2, R3.1, TP6.1, U2.3 (VIN-)
GND: C1.2, C2.2, C3.2, C4.2, C5.2, C6.2, C8.2, C9.2, C10.2, C11.2, D1.2 (A), PS1.3 (-V), R3.2, R8.2, TP9.1, TP10.1, U1.2 (GND), U2.2 (VSS), U3.2 (GND), U3.3 (~CE), U4.2 (GND), U4.3 (~CE), U5.1 (ADJ/GND), U6.1 (GND); also elsewhere on the board
NRESET: R6.2, U6.2 (~RESET); also elsewhere on the board
VSYS: C8.1, C9.1, D1.1 (C), R7.1, TP3.1, U3.6 (VOUT), U4.6 (VOUT), U5.3 (INPUT); also elsewhere on the board
VSYS_SENSE: C11.1, R7.2, R8.1, TP8.1; also elsewhere on the board

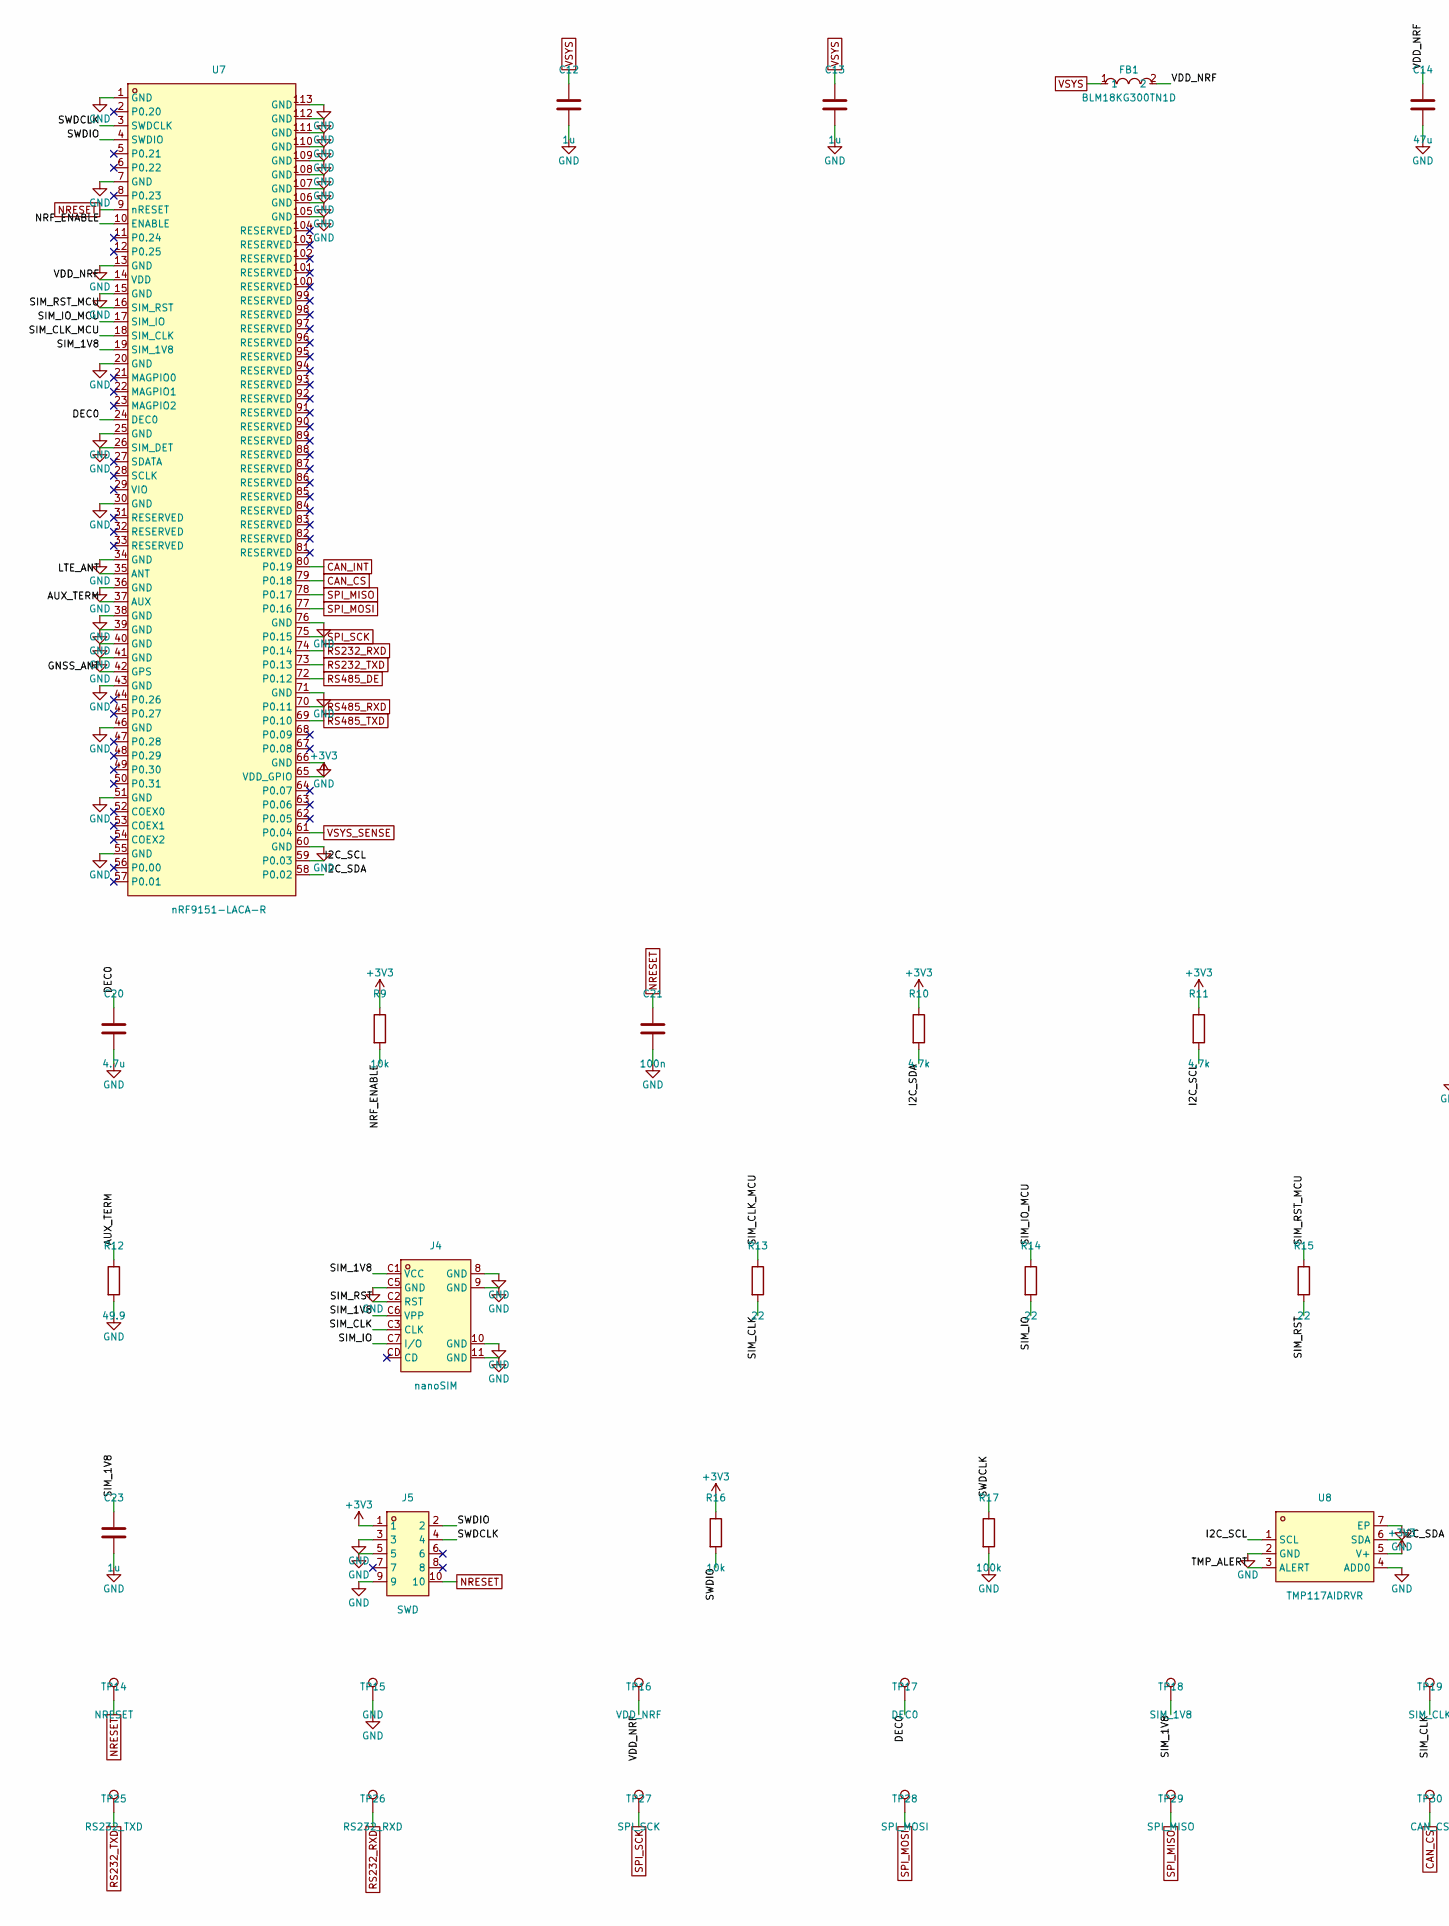
[picture p32: schematic nrf9151.kicad_sch, part in row 1, column 1]

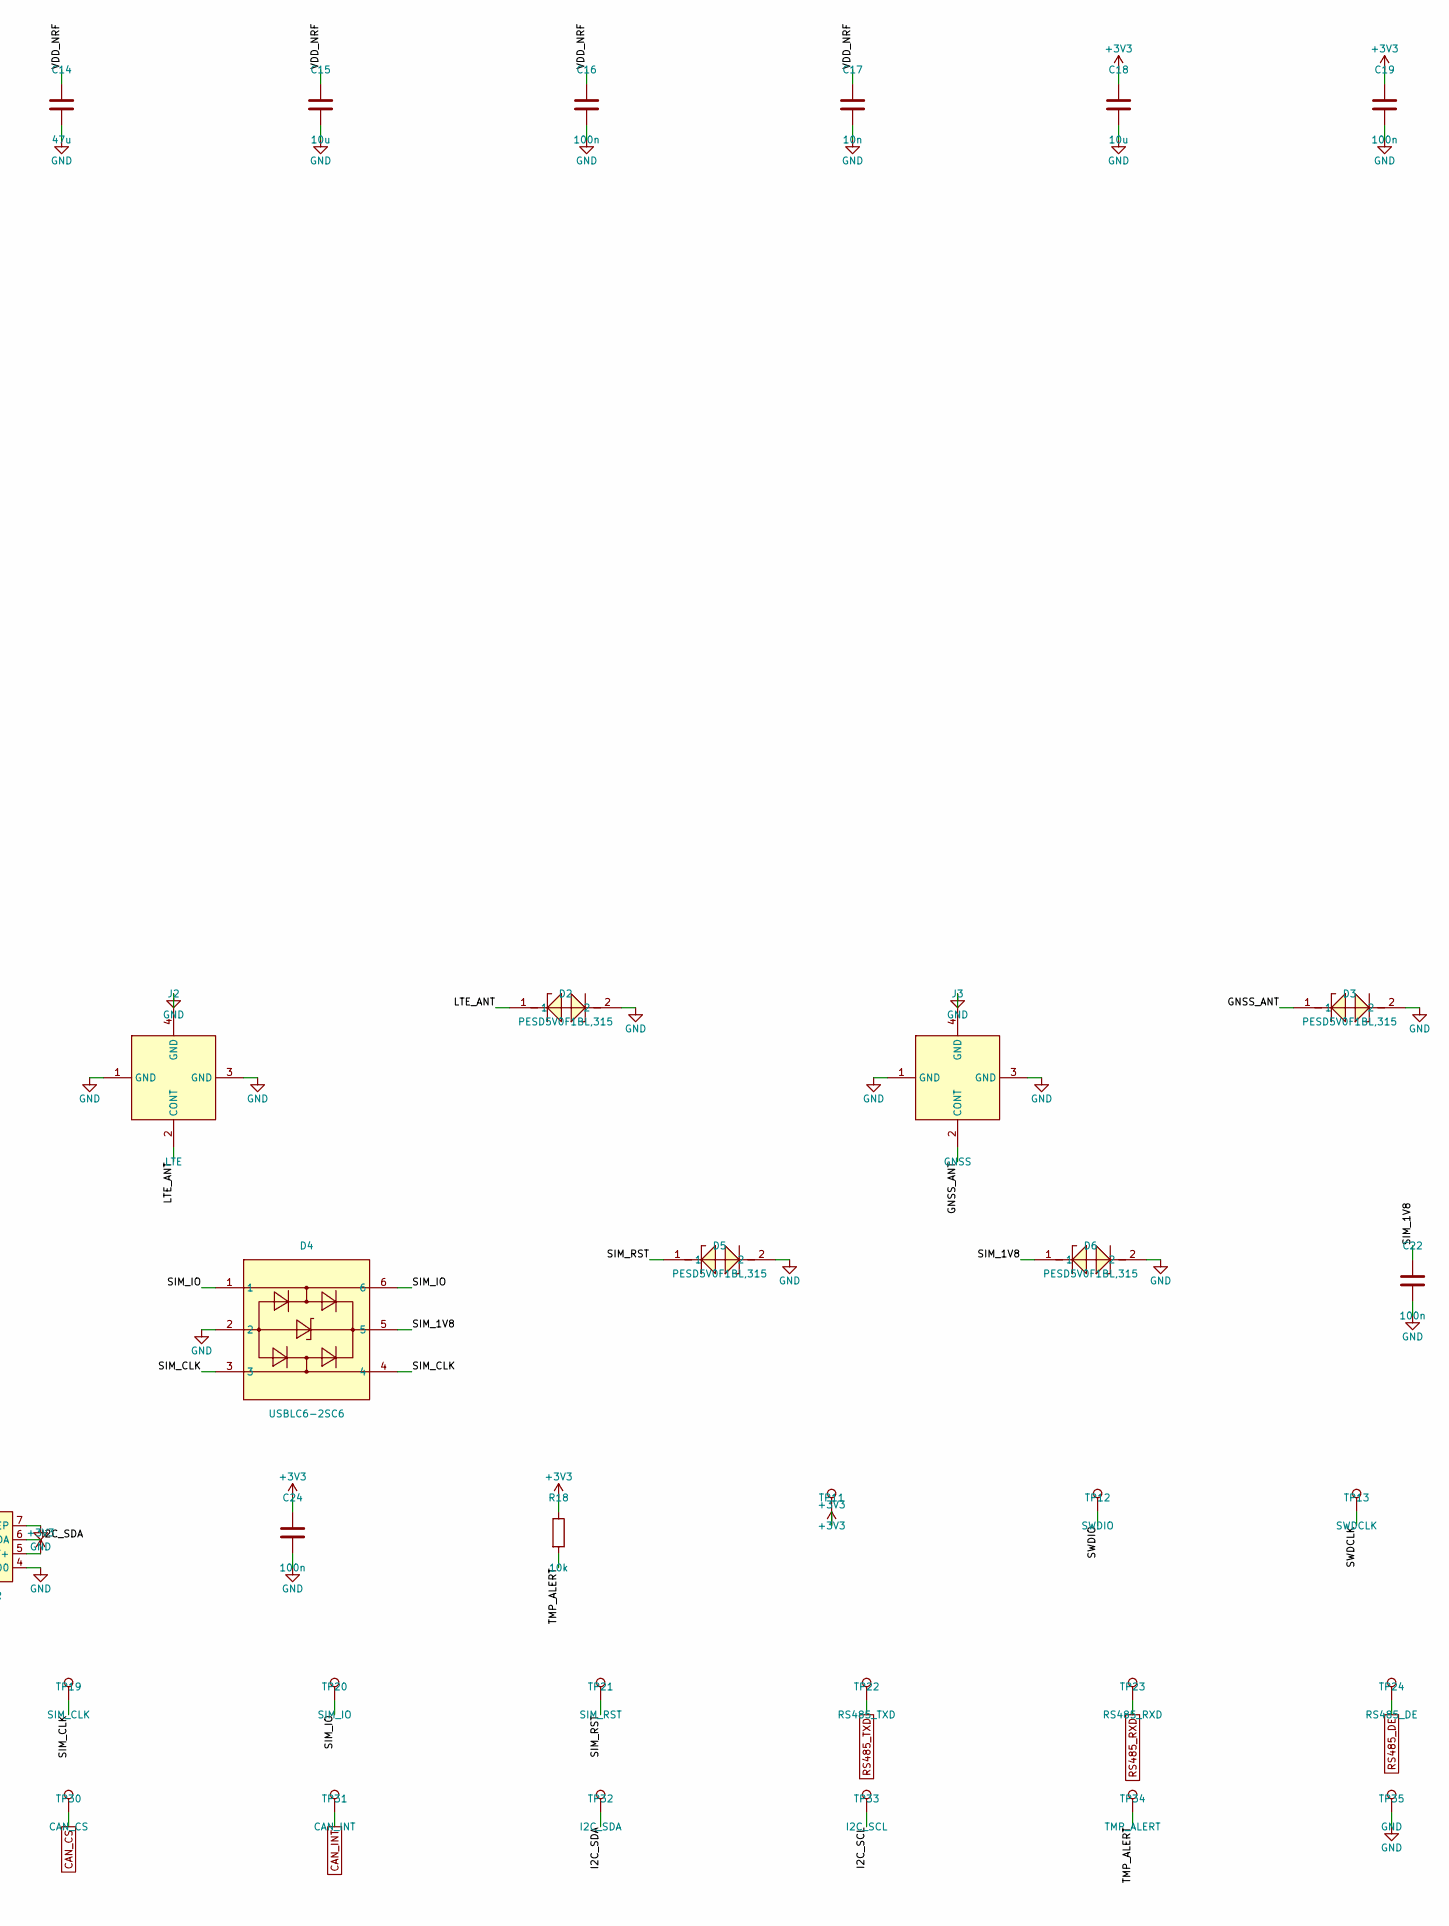
[picture p33: schematic nrf9151.kicad_sch, part in row 1, column 2]

Parts:
C12, C13, C23: 1u; C_0402_1005Metric; LCSC C52923
C14: 47u; C_1206_3216Metric; LCSC C432922
C15, C18: 10u; C_0603_1608Metric; LCSC C19702
C16, C19, C21, C22, C24: 100n; C_0402_1005Metric; LCSC C1525
C17: 10n; C_0402_1005Metric; LCSC C15195
C20: 4.7u; C_0402_1005Metric; LCSC C23733
D2, D3, D5, D6: PESD5V0F1BL,315; SOD-882_L1.0-W0.6-BI; LCSC C45961
D4: USBLC6-2SC6; SOT-23-6_L2.9-W1.6-P0.95-LS2.8-BL; LCSC C7519
FB1: BLM18KG300TN1D; L0603; LCSC C88982
J2: LTE; ANT-SMD_ECT818000500; LCSC C437254
J3: GNSS; ANT-SMD_ECT818000500; LCSC C437254
J4: nanoSIM; SIM-SMD_NANO-SIM-7P-H1.37; LCSC C7529384
J5: SWD; CONN-TH_10P-P1.27_FTSH-105-01-F-D-K; LCSC C9900011230
R9, R16, R18: 10k; R_0402_1005Metric; LCSC C25744
R10, R11: 4.7k; R_0402_1005Metric; LCSC C25900
R12: 49.9; R_0402_1005Metric; LCSC C4165090
R13, R14, R15: 22; R_0402_1005Metric; LCSC C25092
R17: 100k; R_0402_1005Metric; LCSC C25741
TP11: +3V3; TestPoint_Pad_D1.5mm
TP12: SWDIO; TestPoint_Pad_D1.5mm
TP13: SWDCLK; TestPoint_Pad_D1.5mm
TP14: NRESET; TestPoint_Pad_D1.5mm
TP15, TP35: GND; TestPoint_Pad_D1.5mm
TP16: VDD_NRF; TestPoint_Pad_D1.5mm
TP17: DEC0; TestPoint_Pad_D1.5mm
TP18: SIM_1V8; TestPoint_Pad_D1.5mm
TP19: SIM_CLK; TestPoint_Pad_D1.5mm
TP20: SIM_IO; TestPoint_Pad_D1.5mm
TP21: SIM_RST; TestPoint_Pad_D1.5mm
TP22: RS485_TXD; TestPoint_Pad_D1.5mm
TP23: RS485_RXD; TestPoint_Pad_D1.5mm
TP24: RS485_DE; TestPoint_Pad_D1.5mm
TP25: RS232_TXD; TestPoint_Pad_D1.5mm
TP26: RS232_RXD; TestPoint_Pad_D1.5mm
TP27: SPI_SCK; TestPoint_Pad_D1.5mm
TP28: SPI_MOSI; TestPoint_Pad_D1.5mm
TP29: SPI_MISO; TestPoint_Pad_D1.5mm
TP30: CAN_CS; TestPoint_Pad_D1.5mm
TP31: CAN_INT; TestPoint_Pad_D1.5mm
TP32: I2C_SDA; TestPoint_Pad_D1.5mm
TP33: I2C_SCL; TestPoint_Pad_D1.5mm
TP34: TMP_ALERT; TestPoint_Pad_D1.5mm
U7: nRF9151-LACA-R; LGA-113_L12.1-W11.1_NRF9151-LACA-R7; LCSC C42236596
U8: TMP117AIDRVR; WSON-6_L2.0-W2.0-P0.65-TL-EP; LCSC C699536

Connections:
+3V3: C18.1, C19.1, C24.1, J5.1, R9.1, R10.1, R11.1, R16.1, R18.1, TP11.1, U7.65 (VDD_GPIO), U8.5 (V+); also elsewhere on the board
/nRF9151/AUX_TERM: R12.1, U7.37 (AUX)
/nRF9151/DEC0: C20.1, TP17.1, U7.24 (DEC0)
/nRF9151/GNSS_ANT: D3.1, J3.2 (CONT), U7.42 (GPS)
/nRF9151/I2C_SCL: R11.2, TP33.1, U7.59 (P0.03), U8.1 (SCL)
/nRF9151/I2C_SDA: R10.2, TP32.1, U7.58 (P0.02), U8.6 (SDA)
/nRF9151/LTE_ANT: D2.1, J2.2 (CONT), U7.35 (ANT)
/nRF9151/NRF_ENABLE: R9.2, U7.10 (ENABLE)
/nRF9151/SIM_1V8: C22.1, C23.1, D4.5, D6.1, J4.C1 (VCC), J4.C6 (VPP), TP18.1, U7.19 (SIM_1V8)
/nRF9151/SIM_CLK: D4.3, D4.4, J4.C3 (CLK), R13.2, TP19.1
/nRF9151/SIM_CLK_MCU: R13.1, U7.18 (SIM_CLK)
/nRF9151/SIM_IO: D4.1, D4.6, J4.C7 (I/O), R14.2, TP20.1
/nRF9151/SIM_IO_MCU: R14.1, U7.17 (SIM_IO)
/nRF9151/SIM_RST: D5.1, J4.C2 (RST), R15.2, TP21.1
/nRF9151/SIM_RST_MCU: R15.1, U7.16 (SIM_RST)
/nRF9151/SWDCLK: J5.4, R17.1, TP13.1, U7.3 (SWDCLK)
/nRF9151/SWDIO: J5.2, R16.2, TP12.1, U7.4 (SWDIO)
/nRF9151/TMP_ALERT: R18.2, TP34.1, U8.3 (ALERT)
/nRF9151/VDD_NRF: C14.1, C15.1, C16.1, C17.1, FB1.2, TP16.1, U7.14 (VDD)
CAN_CS: TP30.1, U7.79 (P0.18); also elsewhere on the board
CAN_INT: TP31.1, U7.80 (P0.19); also elsewhere on the board
GND: C12.2, C13.2, C14.2, C15.2, C16.2, C17.2, C18.2, C19.2, C20.2, C21.2, C22.2, C23.2, C24.2, D2.2, D3.2, D4.2, D5.2, D6.2, J2.1 (GND), J2.3 (GND), J2.4 (GND), J3.1 (GND), J3.3 (GND), J3.4 (GND), J4.8 (GND), J4.9 (GND), J4.10 (GND), J4.11 (GND), J4.C5 (GND), J5.3, J5.5, J5.9, R12.2, R17.2, TP15.1, TP35.1, U7.1 (GND), U7.7 (GND), U7.13 (GND), U7.15 (GND), U7.20 (GND), U7.25 (GND), U7.26 (SIM_DET), U7.30 (GND), U7.34 (GND), U7.36 (GND), U7.38 (GND), U7.39 (GND), U7.40 (GND), U7.41 (GND), U7.43 (GND), U7.46 (GND), U7.51 (GND), U7.55 (GND), U7.60 (GND), U7.66 (GND), U7.71 (GND), U7.76 (GND), U7.105 (GND), U7.106 (GND), U7.107 (GND), U7.108 (GND), U7.109 (GND), U7.110 (GND), U7.111 (GND), U7.112 (GND), U7.113 (GND), U8.2 (GND), U8.4 (ADD0), U8.7 (EP); also elsewhere on the board
NRESET: C21.1, J5.10, TP14.1, U7.9 (nRESET); also elsewhere on the board
RS232_RXD: TP26.1, U7.74 (P0.14); also elsewhere on the board
RS232_TXD: TP25.1, U7.73 (P0.13); also elsewhere on the board
RS485_DE: TP24.1, U7.72 (P0.12); also elsewhere on the board
RS485_RXD: TP23.1, U7.70 (P0.11); also elsewhere on the board
RS485_TXD: TP22.1, U7.69 (P0.10); also elsewhere on the board
SPI_MISO: TP29.1, U7.78 (P0.17); also elsewhere on the board
SPI_MOSI: TP28.1, U7.77 (P0.16); also elsewhere on the board
SPI_SCK: TP27.1, U7.75 (P0.15); also elsewhere on the board
VSYS: C12.1, C13.1, FB1.1; also elsewhere on the board
VSYS_SENSE: U7.61 (P0.04); also elsewhere on the board

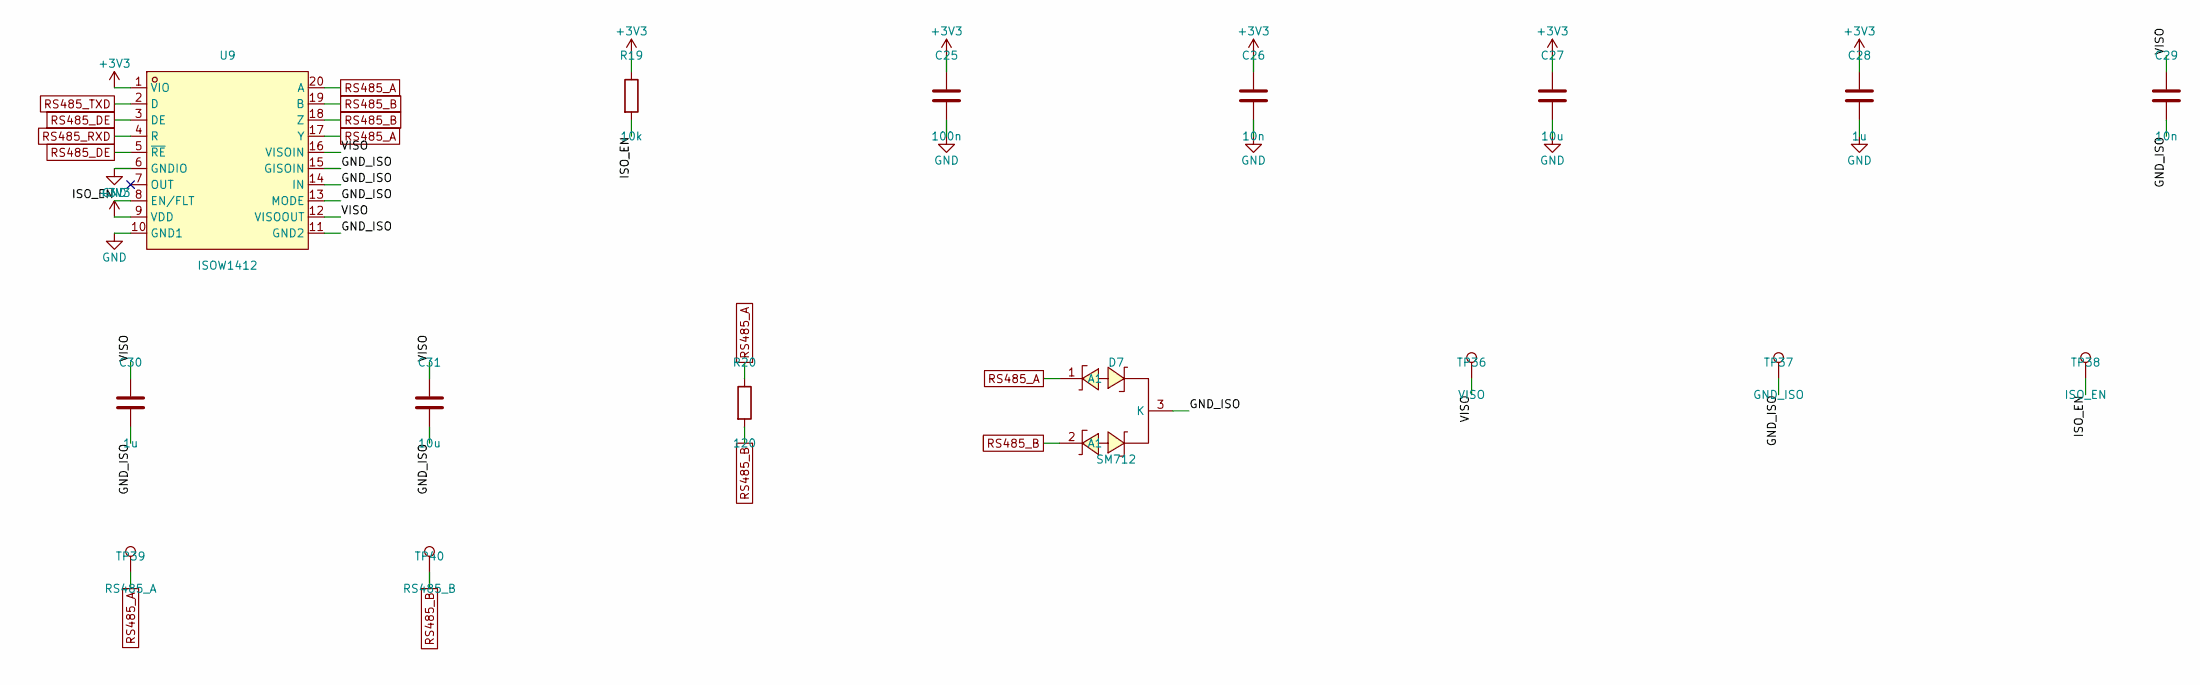
[picture p34: schematic rs485.kicad_sch, Isolated RS-485]

Parts:
C25: 100n; C_0402_1005Metric; LCSC C1525
C26, C29: 10n; C_0402_1005Metric; LCSC C15195
C27, C31: 10u; C_0603_1608Metric; LCSC C19702
C28, C30: 1u; C_0402_1005Metric; LCSC C52923
D7: SM712; SOT-23-3_L3.0-W1.7-P0.95-LS2.9-BR; LCSC C12067
R19: 10k; R_0402_1005Metric; LCSC C25744
R20: 120; R_0402_1005Metric; LCSC C25079
TP36: VISO; TestPoint_Pad_D1.5mm
TP37: GND_ISO; TestPoint_Pad_D1.5mm
TP38: ISO_EN; TestPoint_Pad_D1.5mm
TP39: RS485_A; TestPoint_Pad_D1.5mm
TP40: RS485_B; TestPoint_Pad_D1.5mm
U9: ISOW1412; SOIC-20_L12.8-W7.5-P1.27-LS10.3-TL; LCSC C5216548

Connections:
+3V3: C25.1, C26.1, C27.1, C28.1, R19.1, U9.1 (VIO), U9.9 (VDD); also elsewhere on the board
/Isolated RS-485/GND_ISO: C29.2, C30.2, C31.2, D7.3 (K), TP37.1, U9.11 (GND2), U9.13 (MODE), U9.14 (IN), U9.15 (GISOIN)
/Isolated RS-485/ISO_EN: R19.2, TP38.1, U9.8 (EN/FLT)
/Isolated RS-485/VISO: C29.1, C30.1, C31.1, TP36.1, U9.12 (VISOOUT), U9.16 (VISOIN)
GND: C25.2, C26.2, C27.2, C28.2, U9.6 (GNDIO), U9.10 (GND1); also elsewhere on the board
RS485_A: D7.1 (A1), R20.1, TP39.1, U9.17 (Y), U9.20 (A); also elsewhere on the board
RS485_B: D7.2 (A1), R20.2, TP40.1, U9.18 (Z), U9.19 (B); also elsewhere on the board
RS485_DE: U9.3 (DE), U9.5 (~RE); also elsewhere on the board
RS485_RXD: U9.4 (R); also elsewhere on the board
RS485_TXD: U9.2 (D); also elsewhere on the board

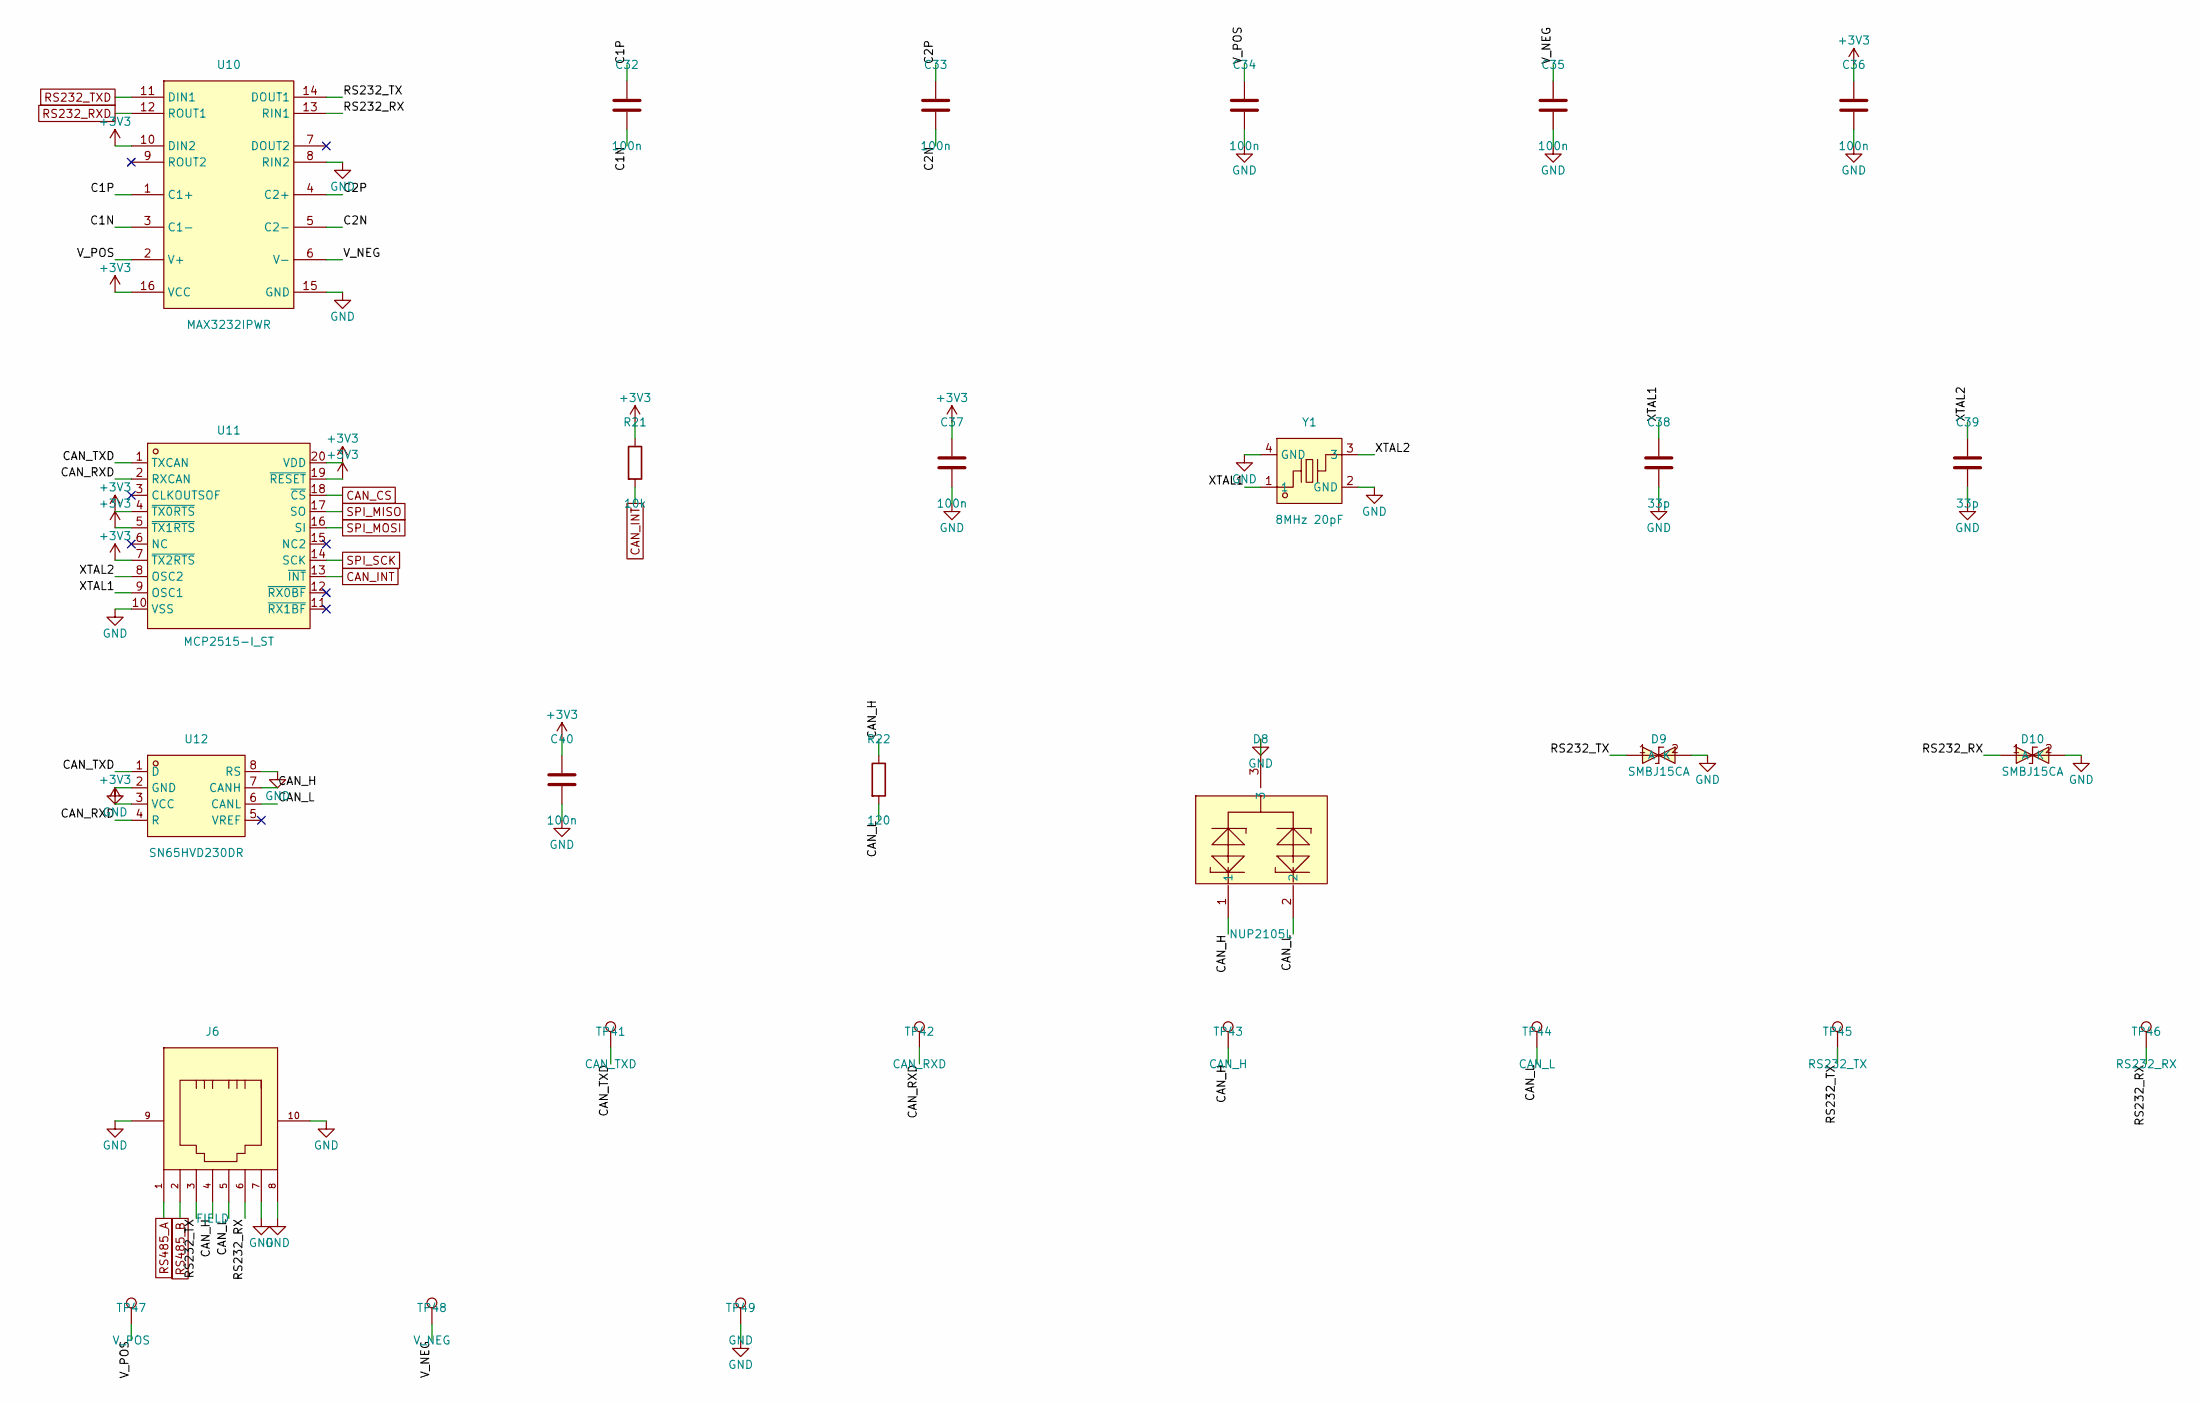
[picture p35: schematic fieldbus.kicad_sch, Fieldbus RS-232 CAN RJ45]

Parts:
C32, C33, C34, C35, C36, C37, C40: 100n; C_0402_1005Metric; LCSC C1525
C38, C39: 33p; C_0402_1005Metric; LCSC C1562
D8: NUP2105L; SOT-23-3_L2.9-W1.3-P1.90-LS2.4-BL-2; LCSC C14486
D9, D10: SMBJ15CA; SMB_L4.6-W3.6-LS5.3-BI; LCSC C78809
J6: FIELD; RJ45-TH_KH-RJ45-56-8P8C; LCSC C2683359
R21: 10k; R_0402_1005Metric; LCSC C25744
R22: 120; R_0402_1005Metric; LCSC C25079
TP41: CAN_TXD; TestPoint_Pad_D1.5mm
TP42: CAN_RXD; TestPoint_Pad_D1.5mm
TP43: CAN_H; TestPoint_Pad_D1.5mm
TP44: CAN_L; TestPoint_Pad_D1.5mm
TP45: RS232_TX; TestPoint_Pad_D1.5mm
TP46: RS232_RX; TestPoint_Pad_D1.5mm
TP47: V_POS; TestPoint_Pad_D1.5mm
TP48: V_NEG; TestPoint_Pad_D1.5mm
TP49: GND; TestPoint_Pad_D1.5mm
U10: MAX3232IPWR; TSSOP-16_L5.0-W4.4-P0.65-LS6.4-BL; LCSC C113205
U11: MCP2515-I_ST; TSSOP-20_L6.5-W4.4-P0.65-LS6.4-BL; LCSC C15193
U12: SN65HVD230DR; SOIC-8_L4.9-W3.9-P1.27-LS6.0-BL; LCSC C12084
Y1: 8MHz 20pF; CRYSTAL-SMD_4P-L3.2-W2.5-BL; LCSC C2682774

Connections:
+3V3: C36.1, C37.1, C40.1, R21.1, U10.10 (DIN2), U10.16 (VCC), U11.4 (~TX0RTS), U11.5 (~TX1RTS), U11.7 (~TX2RTS), U11.19 (~RESET), U11.20 (VDD), U12.3 (VCC); also elsewhere on the board
/Fieldbus RS-232 CAN RJ45/C1N: C32.2, U10.3 (C1-)
/Fieldbus RS-232 CAN RJ45/C1P: C32.1, U10.1 (C1+)
/Fieldbus RS-232 CAN RJ45/C2N: C33.2, U10.5 (C2-)
/Fieldbus RS-232 CAN RJ45/C2P: C33.1, U10.4 (C2+)
/Fieldbus RS-232 CAN RJ45/CAN_H: D8.1, J6.4, R22.1, TP43.1, U12.7 (CANH)
/Fieldbus RS-232 CAN RJ45/CAN_L: D8.2, J6.5, R22.2, TP44.1, U12.6 (CANL)
/Fieldbus RS-232 CAN RJ45/CAN_RXD: TP42.1, U11.2 (RXCAN), U12.4 (R)
/Fieldbus RS-232 CAN RJ45/CAN_TXD: TP41.1, U11.1 (TXCAN), U12.1 (D)
/Fieldbus RS-232 CAN RJ45/RS232_RX: D10.1 (K), J6.6, TP46.1, U10.13 (RIN1)
/Fieldbus RS-232 CAN RJ45/RS232_TX: D9.1 (K), J6.3, TP45.1, U10.14 (DOUT1)
/Fieldbus RS-232 CAN RJ45/V_NEG: C35.1, TP48.1, U10.6 (V-)
/Fieldbus RS-232 CAN RJ45/V_POS: C34.1, TP47.1, U10.2 (V+)
/Fieldbus RS-232 CAN RJ45/XTAL1: C38.1, U11.9 (OSC1), Y1.1
/Fieldbus RS-232 CAN RJ45/XTAL2: C39.1, U11.8 (OSC2), Y1.3
CAN_CS: U11.18 (~CS); also elsewhere on the board
CAN_INT: R21.2, U11.13 (~INT); also elsewhere on the board
GND: C34.2, C35.2, C36.2, C37.2, C38.2, C39.2, C40.2, D8.3, D9.2 (A), D10.2 (A), J6.7, J6.8, J6.9, J6.10, TP49.1, U10.8 (RIN2), U10.15 (GND), U11.10 (VSS), U12.2 (GND), U12.8 (RS), Y1.2 (GND), Y1.4 (GND); also elsewhere on the board
RS232_RXD: U10.12 (ROUT1); also elsewhere on the board
RS232_TXD: U10.11 (DIN1); also elsewhere on the board
RS485_A: J6.1; also elsewhere on the board
RS485_B: J6.2; also elsewhere on the board
SPI_MISO: U11.17 (SO); also elsewhere on the board
SPI_MOSI: U11.16 (SI); also elsewhere on the board
SPI_SCK: U11.14 (SCK); also elsewhere on the board

Board: 4 copper layers, 144 parts (49 on the bottom side), 62 nets, no tracks yet.
